jeremynguyenn/STM32-IoT-Development-board-Hardware-and-Firmware/README.md

Relate to this firmware git: https://github.com/jeremynguyenn/My-driver-Embedded-IoT-Frimware.git
