jeremynguyenn/STM32-IoT-Development-board-Hardware-and-Firmware/IOT development board firmware and hardware/UnderControl-Prototype-main/README.md

# STM32-GPS-GSM-IoT-Board-UnderControl-
IoT board to control smart home and car systems via Bluetooth, wifi, and GSM with embedded CAN transceiver for OBD.
Note: For Sch, Gerber and assembly files or any info you can contact me.
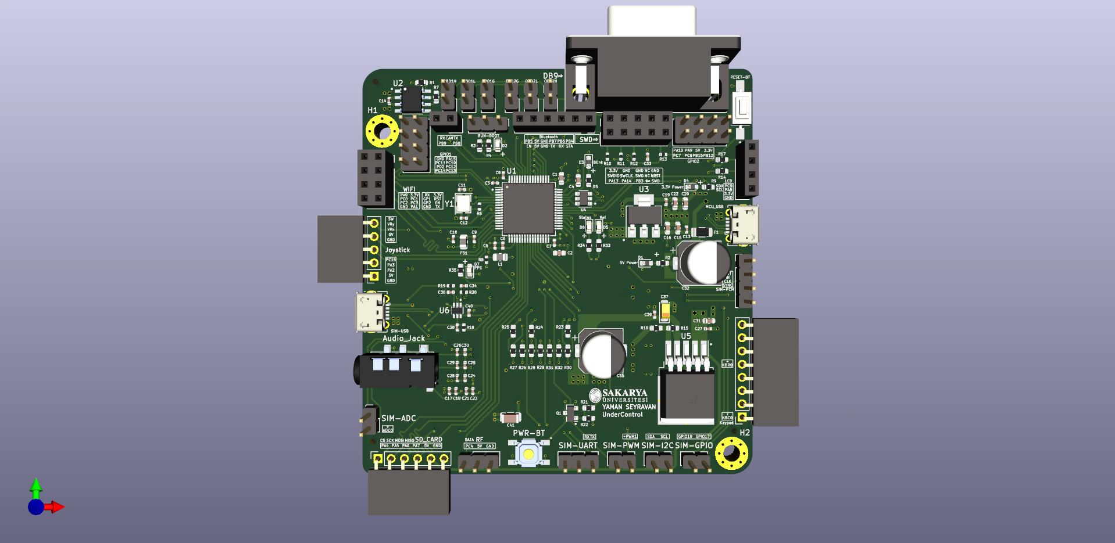
[picture p1: IOT development board firmware and hardware/UnderControl-Prototype-main/pic_PCBversion/Under-Control-F.jpg]

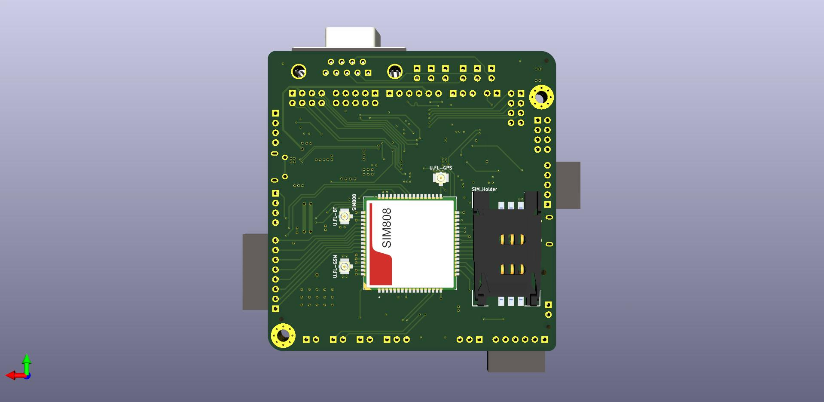
[picture p2: IOT development board firmware and hardware/UnderControl-Prototype-main/pic_PCBversion/Under-Control-B.jpg]

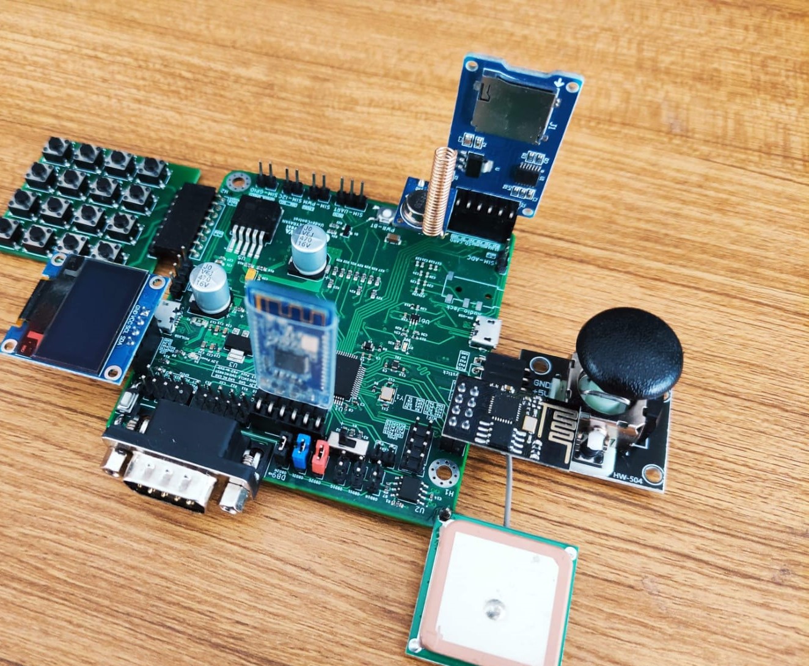
[picture p3: IOT development board firmware and hardware/UnderControl-Prototype-main/pic_PCBversion/UC_F.jpeg]
