jeremynguyenn/STM32-IoT-Development-board-Hardware-and-Firmware/IOT development board firmware and hardware/UnderControl-Prototype-main/Hardware Design/UnderControl.png

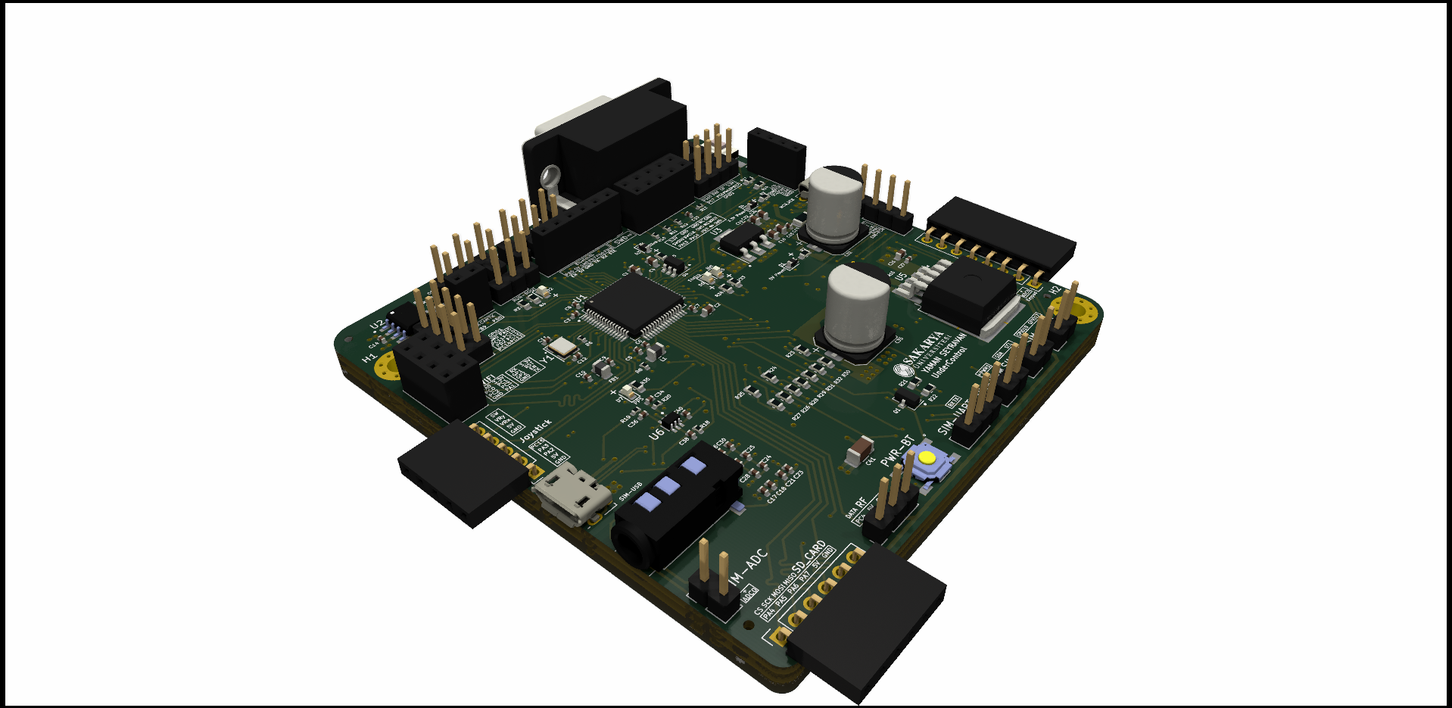
IOT development board firmware and hardware/UnderControl-Prototype-main/Hardware Design/UnderControl.png
