jeremynguyenn/STM32-IoT-Development-board-Hardware-and-Firmware/IOT development board firmware and hardware/UnderControl-Prototype-main/pic_PCBversion/Under-Control-S.jpg

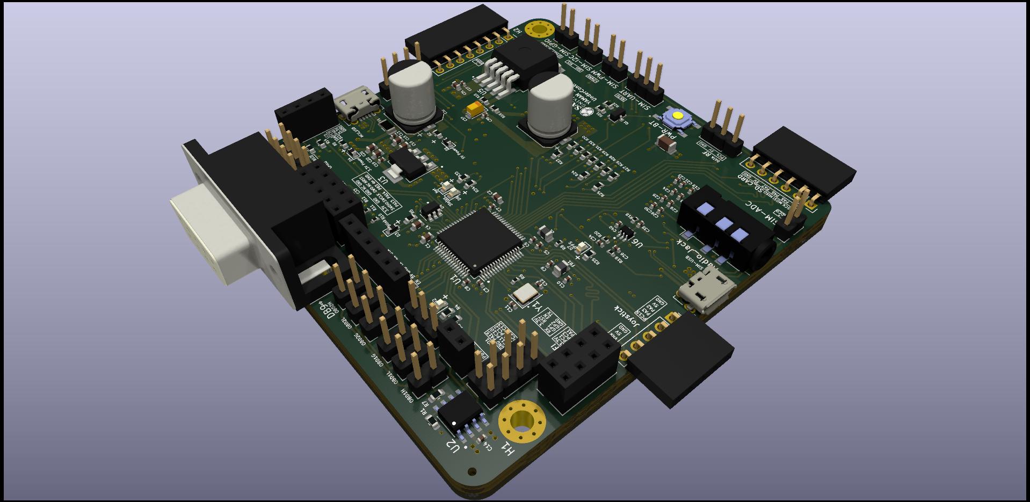
IOT development board firmware and hardware/UnderControl-Prototype-main/pic_PCBversion/Under-Control-S.jpg
