jeremynguyenn/STM32-IoT-Development-board-Hardware-and-Firmware/IOT development board firmware and hardware/UnderControl-Prototype-main/pic_PCBversion/UnderControl-front.jpg

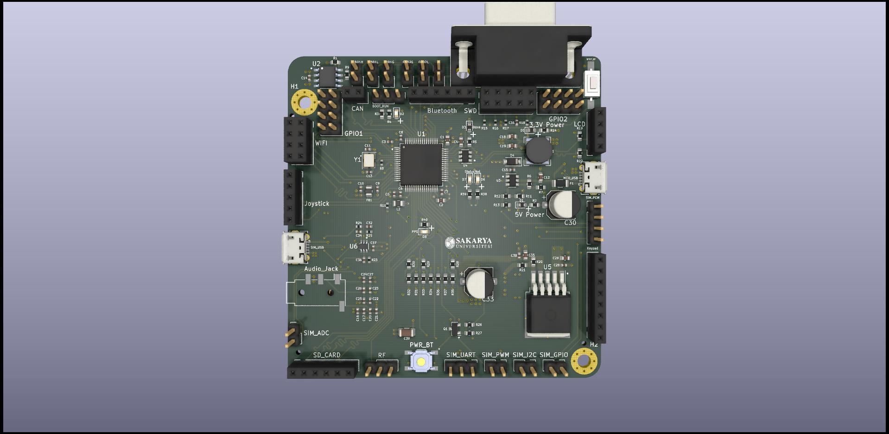
IOT development board firmware and hardware/UnderControl-Prototype-main/pic_PCBversion/UnderControl-front.jpg
