jeremynguyenn/STM32-IoT-Development-board-Hardware-and-Firmware/IOT development board firmware and hardware/UnderControl-Prototype-main/pic_PCBversion/UnderControl-side.jpg

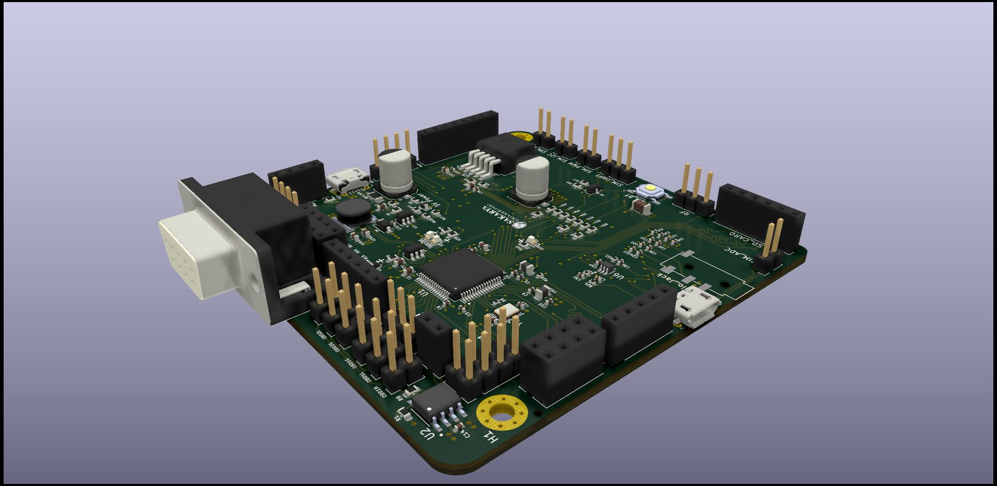
IOT development board firmware and hardware/UnderControl-Prototype-main/pic_PCBversion/UnderControl-side.jpg
