jeremynguyenn/STM32-IoT-Development-board-Hardware-and-Firmware/IOT development board firmware and hardware/UnderControl-Prototype-main/Hardware Design/UnderControl.kicad_pcb

## KiCad design IOT development board firmware and hardware/UnderControl-Prototype-main/Hardware Design/UnderControl.kicad_pcb (2025-09-02)

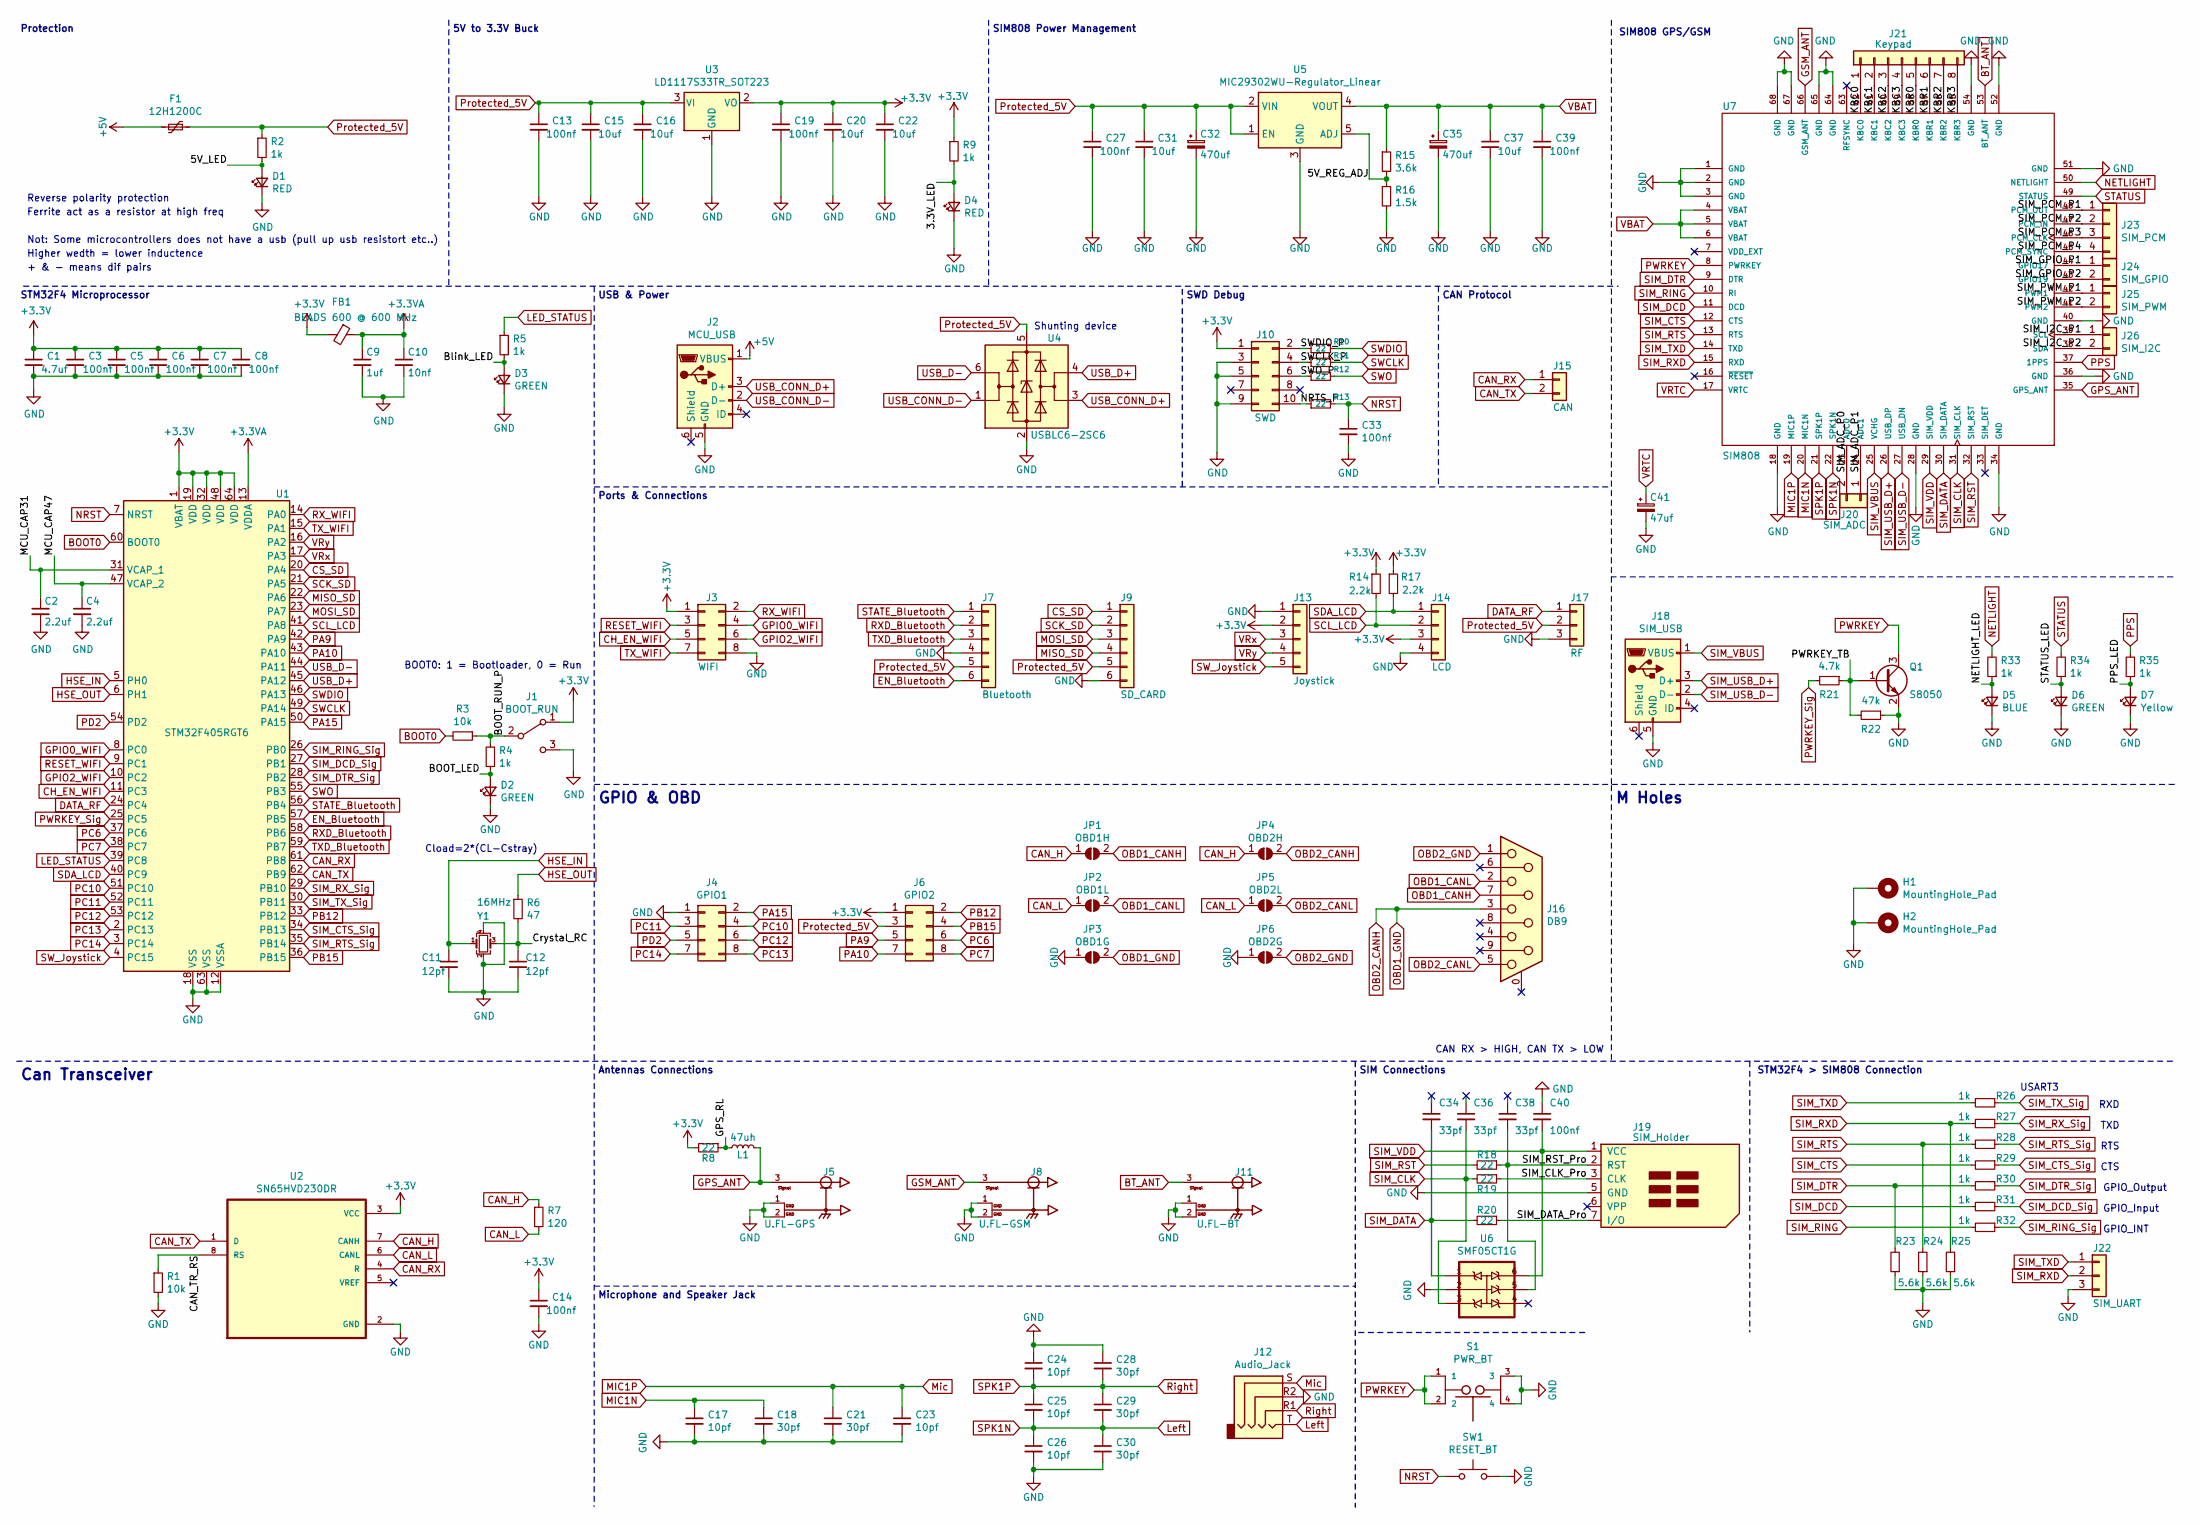
[picture p9: schematic UnderControl.kicad_sch]

Parts:
C1: 4.7uf; C_0603_1608Metric; LCSC Part # C19666
C2, C4: 2.2uf; C_0603_1608Metric; LCSC Part # C23630
C3, C5, C6, C7, C8, C13, C14, C19, C27, C33, C39, C40: 100nf; C_0402_1005Metric; LCSC Part # C1525
C9: 1uf; C_0402_1005Metric; LCSC Part # C52923
C10: 10nf; C_0402_1005Metric; LCSC Part # C15195
C11, C12: 12pf; C_0402_1005Metric; LCSC Part # C1547
C15, C16, C20, C22, C31: 10uf; C_0603_1608Metric; LCSC Part # C19702
C17, C23, C24, C25, C26: 10pf; C_0402_1005Metric; LCSC Part # C32949
C18, C21, C28, C29, C30: 30pf; C_0402_1005Metric; LCSC Part # C1570
C32, C35: 470uf; CP_Elec_8x10; LCSC Part # C176671
C34, C36, C38: 33pf; C_0402_1005Metric; LCSC Part # C1562
C37: 10uf; CP_EIA-3216-18_Kemet-A; LCSC Part # C7171
C41: 47uf; C_1206_3216Metric; LCSC Part # C96123
D1, D4: RED; D_0603_1608Metric; LCSC Part # C2286
D2, D6: GREEN; LED_0603_1608Metric; LCSC Part # C72043
D3: GREEN; D_0603_1608Metric; LCSC Part # C72043
D5: BLUE; LED_0603_1608Metric; LCSC Part # C72041
D7: Yellow; LED_0603_1608Metric; LCSC Part # C72038
F1: 12H1200C; Fuse_1206_3216Metric; LCSC Part # C182310
FB1: BEADS 600 @ 600 MHz; L_0805_2012Metric; LCSC Part # C1017
H1, H2: MountingHole_Pad; MountingHole_3.2mm_M3_Pad_Via
J1: BOOT_RUN; PinHeader_1x03_P2.54mm_Vertical
J2: MCU_USB; USB_Micro_JLCPCB; LCSC Part # C404969
J3: WIFI; PinSocket_2x04_P2.54mm_Vertical
J4: GPIO1; PinHeader_2x04_P2.54mm_Vertical
J5: U.FL-GPS; HRS_U.FL-R-SMT(01); LCSC Part # C88374
J6: GPIO2; PinHeader_2x04_P2.54mm_Vertical
J7: Bluetooth; PinSocket_1x06_P2.54mm_Vertical
J8: U.FL-GSM; HRS_U.FL-R-SMT(01); LCSC Part # C88374
J9: SD_CARD; PinSocket_1x06_P2.54mm_Vertical
J10: SWD; PinSocket_2x05_P2.54mm_Vertical
J11: U.FL-BT; HRS_U.FL-R-SMT(01); LCSC Part # C88374
J12: Audio_Jack; Jack_3.5mm_PJ320D_Horizontal
J13: Joystick; PinSocket_1x05_P2.54mm_Vertical
J14: LCD; PinSocket_1x04_P2.54mm_Vertical
J15: CAN; PinSocket_1x02_P2.54mm_Vertical
J16: DB9; DSUB-9_Female_Horizontal_P2.77x2.84mm_EdgePinOffset4.94mm_H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
J17: RF; PinHeader_1x03_P2.54mm_Vertical
J18: SIM_USB; USB_Micro_JLCPCB; LCSC Part # C404969
J19: SIM_Holder; FCI_7111S2015X02LF
J20: SIM_ADC; PinHeader_1x02_P2.54mm_Vertical
J21: Keypad; PinSocket_1x08_P2.54mm_Vertical
J22: SIM_UART; PinHeader_1x03_P2.54mm_Vertical
J23: SIM_PCM; PinHeader_1x04_P2.54mm_Vertical
J24: SIM_GPIO; PinHeader_1x02_P2.54mm_Vertical
J25: SIM_PWM; PinHeader_1x02_P2.54mm_Vertical
J26: SIM_I2C; PinHeader_1x02_P2.54mm_Vertical
JP1: OBD1H; PinHeader_1x02_P2.54mm_Vertical
JP2: OBD1L; PinHeader_1x02_P2.54mm_Vertical
JP3: OBD1G; PinHeader_1x02_P2.54mm_Vertical
JP4: OBD2H; PinHeader_1x02_P2.54mm_Vertical
JP5: OBD2L; PinHeader_1x02_P2.54mm_Vertical
JP6: OBD2G; PinHeader_1x02_P2.54mm_Vertical
L1: 47uh; L_0805_2012Metric; LCSC Part # C14304
Q1: S8050; SOT-23; LCSC Part # C2146
R1, R3: 10k; R_0603_1608Metric; LCSC Part # C25804
R2, R4, R5, R9, R26, R27, R28, R29, R30, R31, R32, R33, R34, R35: 1k; R_0603_1608Metric; LCSC Part # C21190
R6: 47; R_0402_1005Metric; LCSC Part # C25118
R7: 120; R_0603_1608Metric; LCSC Part # C22787
R8, R10, R11, R12, R13, R18, R19, R20: 22; R_0402_1005Metric; LCSC Part # C25092
R14, R17: 2.2k; R_0603_1608Metric; LCSC Part # C4190
R15: 3.6k; R_0603_1608Metric; LCSC Part # C22980
R16: 1.5k; R_0603_1608Metric; LCSC Part # C22843
R21: 4.7k; R_0603_1608Metric; LCSC Part # C23162
R22: 47k; R_0603_1608Metric; LCSC Part # C25819
R23, R24, R25: 5.6k; R_0603_1608Metric; LCSC Part # C23189
S1: PWR_BT; SW_TL3342F160QG
SW1: RESET_BT; SW_1437566-4
U1: STM32F405RGT6; LQFP-64_10x10mm_P0.5mm; LCSC Part # C15742
U2: SN65HVD230DR; SOIC127P599X175-8N; LCSC Part C12084
U3: LD1117S33TR_SOT223; SOT-223-3_TabPin2; LCSC Part C86781
U4: USBLC6-2SC6; SOT-23-6; LCSC Part # C7519
U5: MIC29302WU-Regulator_Linear; TO-263-5_TabPin3; LCSC Part C11149
U6: SMF05CT1G; SOT65P210X110-6N; LCSC Part # C15879
U7: SIM808; XCVR_SIM808
Y1: 16MHz; Crystal_SMD_3225-4Pin_3.2x2.5mm; LCSC Part # C13738

Connections:
+3.3VA: C9.1, C10.1, FB1.1, U1.13 (VDDA)
+3V3: C1.1, C3.1, C5.1, C6.1, C7.1, C8.1, C14.1, C19.1, C20.1, C22.1, FB1.2, J1.1 (A), J3.1, J6.1, J10.1, J13.2, J14.3, R8.2, R9.1, R14.1, R17.1, U1.1 (VBAT), U1.19 (VDD), U1.32 (VDD), U1.48 (VDD), U1.64 (VDD), U2.3 (VCC), U3.2 (VO)
+5V: F1.2, J2.1 (VBUS)
/3.3V_LED: D4.2 (A), R9.2
/5V_LED: D1.2 (A), R2.2
/5V_REG_ADJ: R15.2, R16.1, U5.5 (ADJ)
/BOOT_LED: D2.2 (A), R4.1
/BOOT_RUN_P: J1.2 (B), R3.1, R4.2
/Blink_LED: D3.2 (A), R5.2
/CAN_TR_RS: R1.1, U2.8 (RS)
/Crystal_RC: C12.1, R6.2, Y1.3
/GPS_RL: L1.1, R8.1
/KBC0: J21.1, U7.62 (KBC0)
/KBC1: J21.2, U7.61 (KBC1)
/KBC2: J21.3, U7.60 (KBC2)
/KBC3: J21.4, U7.59 (KBC3)
/KBR0: J21.5, U7.58 (KBR0)
/KBR1: J21.6, U7.57 (KBR1)
/KBR2: J21.7, U7.56 (KBR2)
/KBR3: J21.8, U7.55 (KBR3)
/MCU_CAP31: C2.1, U1.31 (VCAP_1)
/MCU_CAP47: C4.1, U1.47 (VCAP_2)
/NETLIGHT_LED: D5.2 (A), R33.1
/NRTS_P: J10.10, R13.1
/PPS_LED: D7.2 (A), R35.1
/PWRKEY_TB: Q1.1 (B), R21.1, R22.2
/SIM_ADC_P0: J20.2, U7.23 (ADC0)
/SIM_ADC_P1: J20.1, U7.24 (ADC1)
/SIM_CLK_Pro: J19.3 (CLK), R19.1
/SIM_DATA_Pro: J19.7 (I/O), R20.1
/SIM_GPIO_P1: J24.1, U7.44 (GPIO17)
/SIM_GPIO_P2: J24.2, U7.43 (GPIO19)
/SIM_I2C_P1: J26.1, U7.39 (SCL)
/SIM_I2C_P2: J26.2, U7.38 (SDA)
/SIM_PCM_P1: J23.1, U7.48 (PCM_OUT)
/SIM_PCM_P2: J23.2, U7.47 (PCM_IN)
/SIM_PCM_P3: J23.3, U7.46 (PCM_CLK)
/SIM_PCM_P4: J23.4, U7.45 (PCM_SYNC)
/SIM_PWM_P1: J25.1, U7.42 (PWM1)
/SIM_PWM_P2: J25.2, U7.41 (PWM2)
/SIM_RST_Pro: C38.2, J19.2 (RST), R18.1, U6.5
/STATUS_LED: D6.2 (A), R34.1
/SWCLK_P: J10.4, R11.1
/SWDIO_P: J10.2, R10.1
/SWO_P: J10.6, R12.1
BOOT0: R3.2, U1.60 (BOOT0)
BT_ANT: J11.3, U7.53 (BT_ANT)
CAN_H: JP1.1 (A), JP4.1 (A), R7.1, U2.7 (CANH)
CAN_L: JP2.1 (A), JP5.1 (A), R7.2, U2.6 (CANL)
CAN_RX: J15.1, U1.61 (PB8), U2.4 (R)
CAN_TX: J15.2, U1.62 (PB9), U2.1 (D)
CH_EN_WIFI: J3.5, U1.11 (PC3)
CS_SD: J9.1, U1.20 (PA4)
DATA_RF: J17.1, U1.24 (PC4)
EN_Bluetooth: J7.6, U1.57 (PB5)
GND: C1.2, C2.2, C3.2, C4.2, C5.2, C6.2, C7.2, C8.2, C9.2, C10.2, C11.2, C12.2, C13.2, C14.2, C15.2, C16.2, C17.2, C18.2, C19.2, C20.2, C21.2, C22.2, C23.2, C24.1, C26.2, C27.2, C28.1, C30.2, C31.2, C32.2, C33.2, C35.2, C37.2, C39.2, C40.1, C41.2, D1.1 (K), D2.1 (K), D3.1 (K), D4.1 (K), D5.1 (K), D6.1 (K), D7.1 (K), H1.1, H2.1, J1.3 (C), J2.5 (GND), J3.8, J4.1, J5.1, J5.2, J7.4, J8.1, J8.2, J9.6, J10.3, J10.5, J10.9, J11.1, J11.2, J12.R2, J13.1, J14.4, J17.3, J18.5 (GND), J19.5 (GND), J22.3, JP3.1 (A), JP6.1 (A), Q1.2 (E), R1.2, R16.2, R22.1, R23.1, R24.1, R25.1, S1.3, S1.4, SW1.2, U1.12 (VSSA), U1.18 (VSS), U1.63 (VSS), U2.2 (GND), U3.1 (GND), U4.2 (GND), U5.3 (GND), U6.2, U7.1 (GND), U7.2 (GND), U7.3 (GND), U7.18 (GND), U7.28 (GND), U7.34 (GND), U7.36 (GND), U7.40 (GND), U7.51 (GND), U7.52 (GND), U7.54 (GND), U7.64 (GND), U7.65 (GND), U7.67 (GND), U7.68 (GND), Y1.2, Y1.4
GPIO0_WIFI: J3.4, U1.8 (PC0)
GPIO2_WIFI: J3.6, U1.10 (PC2)
GPS_ANT: J5.3, L1.2, U7.35 (GPS_ANT)
GSM_ANT: J8.3, U7.66 (GSM_ANT)
HSE_IN: C11.1, U1.5 (PH0), Y1.1
HSE_OUT: R6.1, U1.6 (PH1)
LED_STATUS: R5.1, U1.39 (PC8)
Left: C25.2, C26.1, C29.2, C30.1, J12.T, U7.22 (SPK1N)
MIC1N: C17.1, C18.1, U7.20 (MIC1N)
MIC1P: C21.1, C23.1, J12.S, U7.19 (MIC1P)
MISO_SD: J9.4, U1.22 (PA6)
MOSI_SD: J9.3, U1.23 (PA7)
NETLIGHT: R33.2, U7.50 (NETLIGHT)
NRST: C33.1, R13.2, SW1.1, U1.7 (NRST)
OBD1_CANH: J16.7, JP1.2 (B)
OBD1_CANL: J16.2, JP2.2 (B)
OBD1_GND: J16.3, JP3.2 (B), JP4.2 (B)
OBD2_CANL: J16.5, JP5.2 (B)
OBD2_GND: J16.1, JP6.2 (B)
PA9: J6.5, U1.42 (PA9)
PA10: J6.7, U1.43 (PA10)
PA15: J4.2, U1.50 (PA15)
PB12: J6.2, U1.33 (PB12)
PB15: J6.4, U1.36 (PB15)
PC6: J6.6, U1.37 (PC6)
PC7: J6.8, U1.38 (PC7)
PC10: J4.4, U1.51 (PC10)
PC11: J4.3, U1.52 (PC11)
PC12: J4.6, U1.53 (PC12)
PC13: J4.8, U1.2 (PC13)
PC14: J4.7, U1.3 (PC14)
PD2: J4.5, U1.54 (PD2)
PPS: R35.2, U7.37 (1PPS)
PWRKEY: Q1.3 (C), S1.1, S1.2, U7.8 (PWRKEY)
PWRKEY_Sig: R21.2, U1.25 (PC5)
Protected_5V: C13.1, C15.1, C16.1, C27.1, C31.1, C32.1, F1.1, J6.3, J7.5, J9.5, J17.2, R2.1, U3.3 (VI), U4.5 (VBUS), U5.1 (EN), U5.2 (VIN)
RESET_WIFI: J3.3, U1.9 (PC1)
RXD_Bluetooth: J7.2, U1.58 (PB6)
RX_WIFI: J3.2, U1.14 (PA0)
Right: C24.2, C25.1, C28.2, C29.1, J12.R1, U7.21 (SPK1P)
SCK_SD: J9.2, U1.21 (PA5)
SCL_LCD: J14.2, R14.2, U1.41 (PA8)
SDA_LCD: J14.1, R17.2, U1.40 (PC9)
SIM_CLK: C36.2, R19.2, U6.3, U7.31 (SIM_CLK)
SIM_CTS: R29.2, U7.12 (CTS)
SIM_CTS_Sig: R29.1, U1.34 (PB13)
SIM_DATA: C34.2, R20.2, U6.1, U7.30 (SIM_DATA)
SIM_DCD: R31.2, U7.11 (DCD)
SIM_DCD_Sig: R31.1, U1.27 (PB1)
SIM_DTR: R23.2, R30.2, U7.9 (DTR)
SIM_DTR_Sig: R30.1, U1.28 (PB2)
SIM_RING: R32.2, U7.10 (RI)
SIM_RING_Sig: R32.1, U1.26 (PB0)
SIM_RST: R18.2, U7.32 (SIM_RST)
SIM_RTS: R24.2, R28.2, U7.13 (RTS)
SIM_RTS_Sig: R28.1, U1.35 (PB14)
SIM_RXD: J22.2, R25.2, R27.2, U7.15 (RXD)
SIM_RX_Sig: R27.1, U1.29 (PB10)
SIM_TXD: J22.1, R26.2, U7.14 (TXD)
SIM_TX_Sig: R26.1, U1.30 (PB11)
SIM_USB_D+: J18.3 (D+), U7.26 (USB_DP)
SIM_USB_D-: J18.2 (D-), U7.27 (USB_DN)
SIM_VBUS: J18.1 (VBUS), U7.25 (VCHG)
SIM_VDD: C40.2, J19.1 (VCC), U6.6, U7.29 (SIM_VDD)
STATE_Bluetooth: J7.1, U1.56 (PB4)
STATUS: R34.2, U7.49 (STATUS)
SWCLK: R11.2, U1.49 (PA14)
SWDIO: R10.2, U1.46 (PA13)
SWO: R12.2, U1.55 (PB3)
SW_Joystick: J13.5, U1.4 (PC15)
TXD_Bluetooth: J7.3, U1.59 (PB7)
TX_WIFI: J3.7, U1.15 (PA1)
USB_CONN_D+: J2.3 (D+), U4.3 (I/O2)
USB_CONN_D-: J2.2 (D-), U4.1 (I/O1)
USB_D+: U1.45 (PA12), U4.4 (I/O2)
USB_D-: U1.44 (PA11), U4.6 (I/O1)
VBAT: C35.1, C37.1, C39.1, R15.1, U5.4 (VOUT), U7.4 (VBAT), U7.5 (VBAT), U7.6 (VBAT)
VRTC: C41.1, U7.17 (VRTC)
VRx: J13.3, U1.17 (PA3)
VRy: J13.4, U1.16 (PA2)

Notes on the sheet:
Protection
STM32F4 Microprocessor
Can Transceiver
Reverse polarity protection
Ferrite act as a resistor at high freq
Not: Some microcontrollers does not have a usb (pull up usb resistort etc..)
Higher wedth = lower inductence
+ & - means dif pairs
BOOT0: 1 = Bootloader, 0 = Run
Cload=2*(CL-Cstray)
5V to 3.3V Buck
USB & Power
Ports & Connections
GPIO & OBD
Antennas Connections
Microphone and Speaker Jack
SIM808 Power Management
Shunting device
SWD Debug
SIM Connections
CAN RX > HIGH, CAN TX > LOW
CAN Protocol
M Holes
SIM808 GPS/GSM
STM32F4 > SIM808 Connection
USART3
GPIO_Output
GPIO_Input
GPIO_INT
RXD
TXD
RTS
CTS

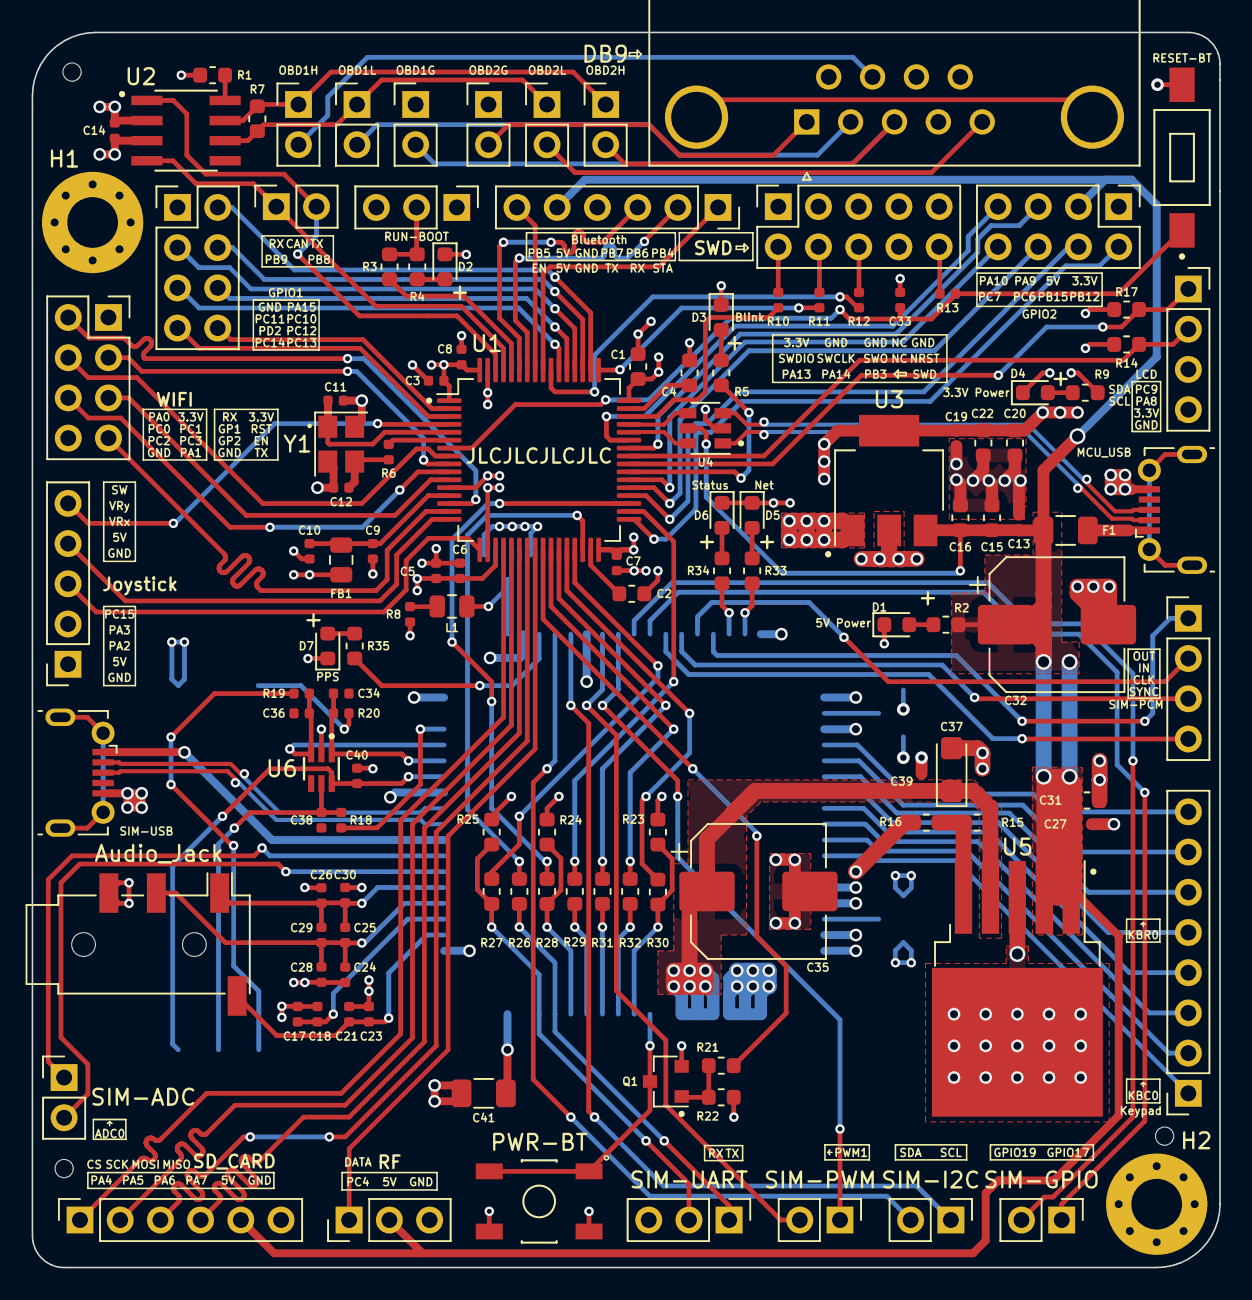
[picture p10: board UnderControl.kicad_pcb from above]

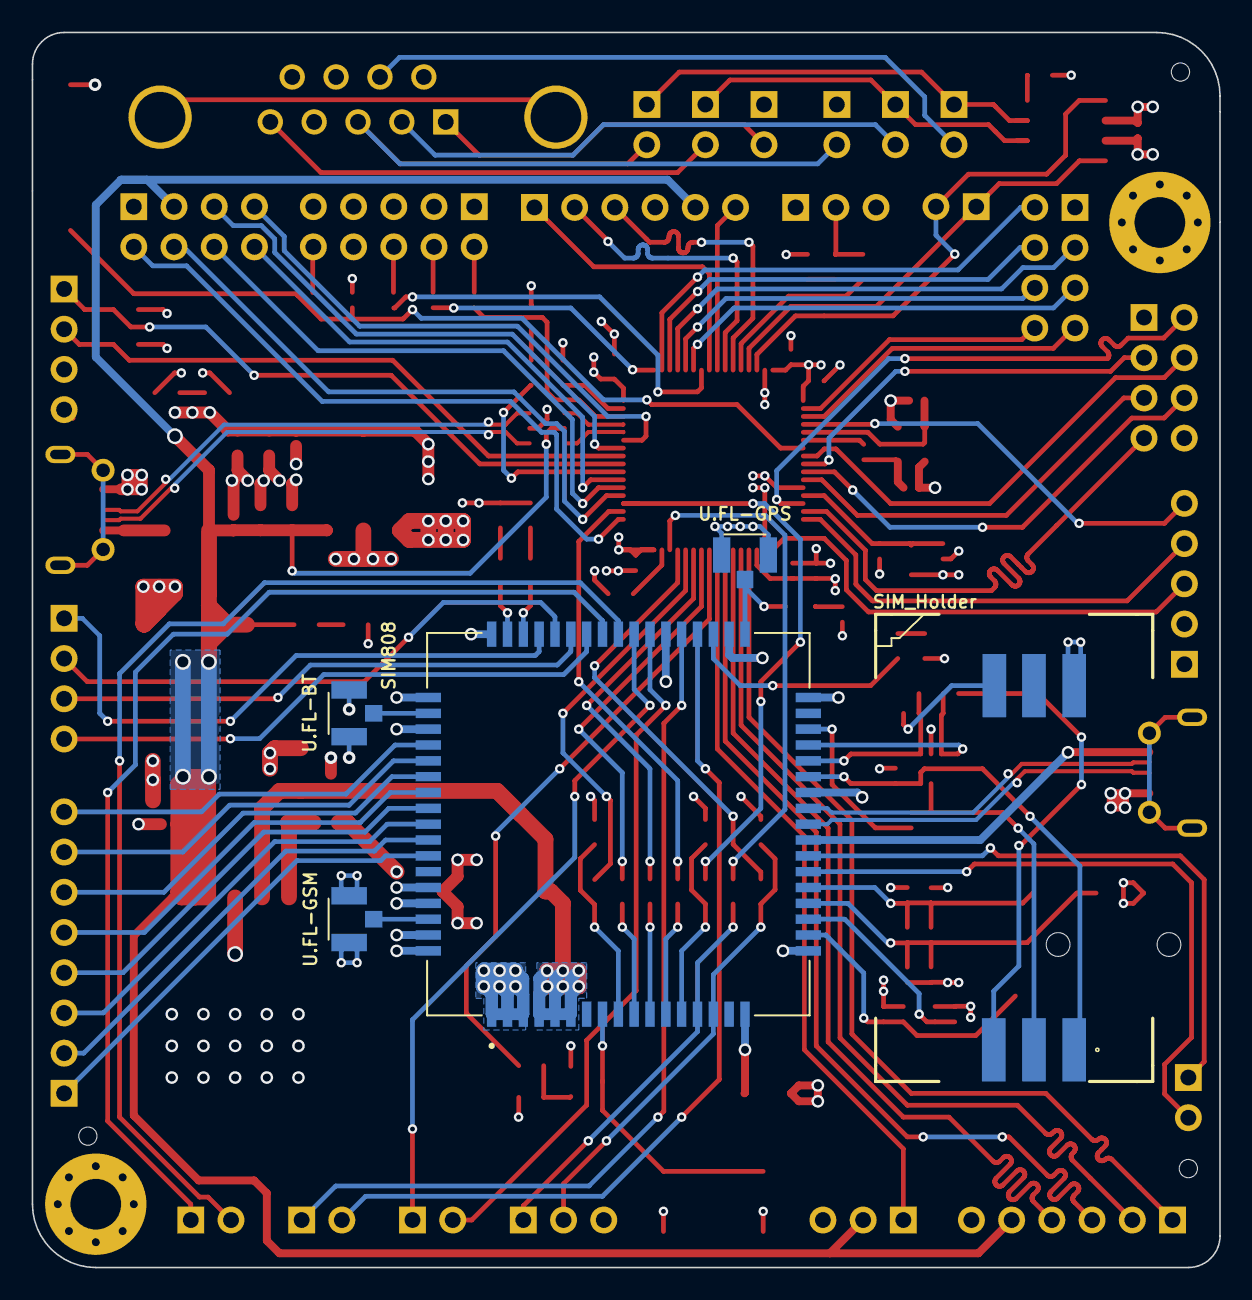
[picture p11: board UnderControl.kicad_pcb from below]

Board: 4 copper layers, 75.0 x 78.0 mm, 131 parts (5 on the bottom side), 136 nets.
