jeremynguyenn/STM32-IoT-Development-board-Hardware-and-Firmware/IOT development board firmware and hardware/UnderControl_Hardware_Design-main/Hardware Design/UnderControl_V6.kicad_pcb

## KiCad design IOT development board firmware and hardware/UnderControl_Hardware_Design-main/Hardware Design/UnderControl_V6.kicad_pcb (2025-09-02)

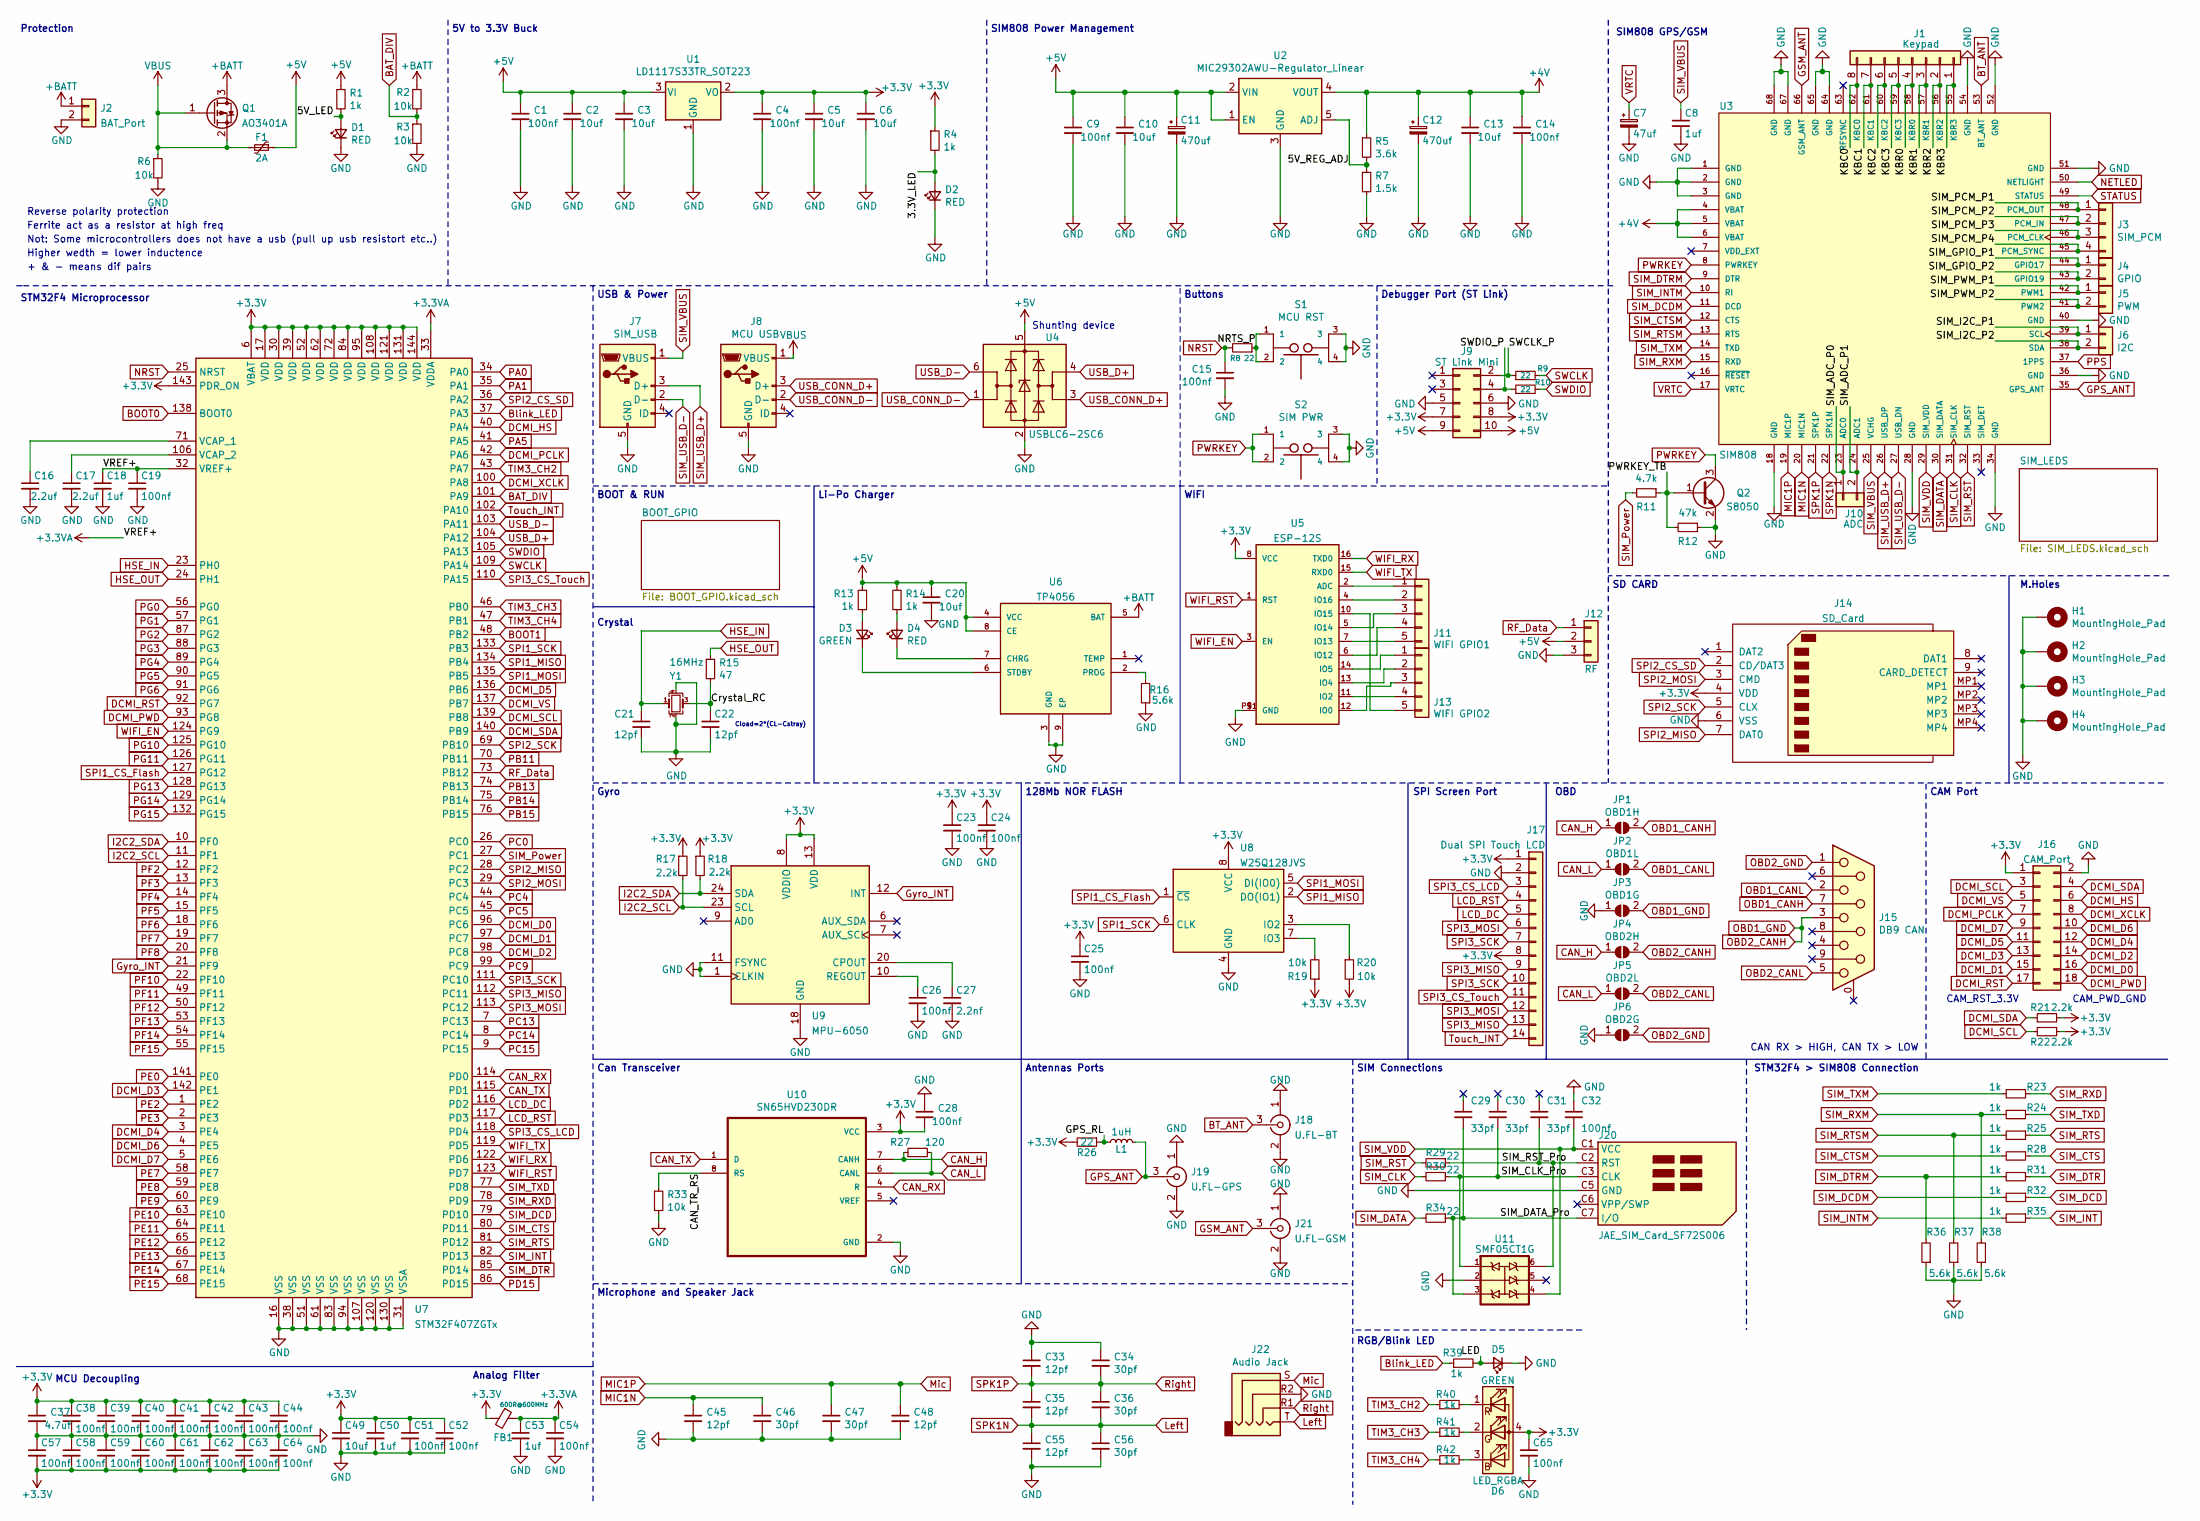
[picture p12: schematic UnderControl_V6.kicad_sch, UnderControl]

Parts:
C1, C4, C9, C14, C15, C19, C23, C24, C25, C26, C28, C32, C38, C39, C40, C41, C42, C43, C44, C51, C52, C54, C57, C58, C59, C60, C61, C62, C63, C64, C65: 100nf; C_0402_1005Metric; LCSC C1525
C2, C3, C5, C6, C10, C13, C20, C49: 10uf; C_0603_1608Metric; LCSC C19702
C7: 47uf; C_1206_3216Metric; LCSC C96123
C8, C18, C50, C53: 1uf; C_0402_1005Metric; LCSC C52923
C11, C12: 470uf; CP_Elec_6.3x7.7; LCSC C134738
C16, C17: 2.2uf; C_0402_1005Metric; LCSC C12530
C21, C22, C33, C35, C45, C48, C55: 12pf; C_0402_1005Metric; LCSC C1547
C27: 2.2nf; C_0402_1005Metric; LCSC C1531
C29, C30, C31: 33pf; C_0402_1005Metric; LCSC C1531
C34, C36, C46, C47, C56: 30pf; C_0402_1005Metric; LCSC C1570
C37: 4.7uf; C_0402_1005Metric; LCSC C23733
D1, D2, D4: RED; LED_0805_2012Metric; LCSC C84256
D3, D5: GREEN; LED_0603_1608Metric; LCSC C72043
D6: LED_RGBA; 19237R6GHBHCA012T; LCSC C60105
F1: 2A; Fuse_1206_3216Metric; LCSC C187595
FB1: 600R@600MHz; L_0805_2012Metric; LCSC C1017
H1, H2, H3, H4: MountingHole_Pad; MountingHole_2.5mm_Pad_Via
J1: Keypad; PinSocket_1x08_P2.54mm_Vertical
J2: BAT_Port; JST_B2B-XH-A(LF)(SN)
J3: SIM_PCM; PinHeader_1x04_P2.54mm_Vertical
J4: GPIO; PinHeader_1x02_P2.54mm_Vertical
J5: PWM; PinHeader_1x02_P2.54mm_Vertical
J6: I2C; PinHeader_1x02_P2.54mm_Vertical
J7: SIM_USB; AMPHENOL_10118194-0001LF; LCSC C132563
J8: MCU USB; AMPHENOL_10118194-0001LF; LCSC C132563
J9: ST Link Mini; PinSocket_2x05_P2.54mm_Horizontal
J10: ADC; PinHeader_1x02_P2.54mm_Vertical
J11: WIFI GPIO1; PinSocket_1x05_P2.54mm_Vertical
J12: RF; PinHeader_1x03_P2.54mm_Vertical
J13: WIFI GPIO2; PinSocket_1x05_P2.54mm_Vertical
J14: SD_Card; TF15X15; LCSC C111196
J15: DB9 CAN; DSUB-9_Female_Horizontal_P2.77x2.84mm_EdgePinOffset4.94mm_H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
J16: CAM_Port; PinSocket_2x09_P2.54mm_Vertical
J17: Dual SPI Touch LCD; PinSocket_1x14_P2.54mm_Vertical
J18: U.FL-BT; HRS_U.FL-R-SMT(01); LCSC C88374
J19: U.FL-GPS; HRS_U.FL-R-SMT(01); LCSC C88374
J20: JAE_SIM_Card_SF72S006; GCT_SIM8060-6-1-14-00-A; LCSC C410356
J21: U.FL-GSM; HRS_U.FL-R-SMT(01); LCSC C88374
J22: Audio Jack; Jack_3.5mm_PJ320D_Horizontal
JP1: OBD1H; SolderJumper-2_P1.3mm_Open_TrianglePad1.0x1.5mm
JP2: OBD1L; SolderJumper-2_P1.3mm_Open_TrianglePad1.0x1.5mm
JP3: OBD1G; SolderJumper-2_P1.3mm_Open_TrianglePad1.0x1.5mm
JP4: OBD2H; SolderJumper-2_P1.3mm_Open_TrianglePad1.0x1.5mm
JP5: OBD2L; SolderJumper-2_P1.3mm_Open_TrianglePad1.0x1.5mm
JP6: OBD2G; SolderJumper-2_P1.3mm_Open_TrianglePad1.0x1.5mm
L1: 1uH; L_0805_2012Metric; LCSC C1042
Q1: AO3401A; SOT-23; LCSC C15127
Q2: S8050; SOT-23; LCSC C2146
R1, R4, R13, R14, R23, R24, R25, R28, R31, R32, R35, R39, R40, R41, R42: 1k; R_0402_1005Metric; LCSC C11702
R2, R3, R6, R19, R20, R33: 10k; R_0402_1005Metric; LCSC C25744
R5: 3.6k; R_0603_1608Metric; LCSC C22980
R7: 1.5k; R_0603_1608Metric; LCSC C22843
R8, R9, R10, R26, R29, R30, R34: 22; R_0402_1005Metric; LCSC C25092
R11: 4.7k; R_0402_1005Metric; LCSC C25900
R12: 47k; R_0402_1005Metric; LCSC C25792
R15: 47; R_0402_1005Metric; LCSC C25118
R16, R36, R37, R38: 5.6k; R_0402_1005Metric; LCSC C25908
R17, R18, R21, R22: 2.2k; R_0402_1005Metric; LCSC C25879
R27: 120; R_0402_1005Metric; LCSC C25079
S1: MCU RST; SW_TL3342F160QG; LCSC C318884
S2: SIM PWR; SW_TL3342F160QG; LCSC C318884
U1: LD1117S33TR_SOT223; SOT-223-3_TabPin2; LCSC C86781
U2: MIC29302AWU-Regulator_Linear; TO-263-5_TabPin3; LCSC C411869
U3: SIM808; XCVR_SIM808; LCSC C126275
U4: USBLC6-2SC6; SOT-23-6; LCSC C2827654
U5: ESP-12S; LCSC C82898
U6: TP4056; SOIC127P600X175-9N; LCSC C16581
U7: STM32F407ZGTx; LQFP-144_20x20mm_P0.5mm; LCSC C19156
U8: W25Q128JVS; SOIC-8_5.23x5.23mm_P1.27mm; LCSC C97521
U9: MPU-6050; InvenSense_QFN-24_4x4mm_P0.5mm_NoMask; LCSC C24112
U10: SN65HVD230DR; SOIC127P599X175-8N; LCSC C12084
U11: SMF05CT1G; SOT65P210X110-6N; LCSC C15879
Y1: 16MHz; Crystal_SMD_3225-4Pin_3.2x2.5mm; LCSC C13738

Connections:
+3.3VA: C18.1, C19.1, C53.1, C54.1, FB1.1, U7.32 (VREF+), U7.33 (VDDA)
+3V3: C4.1, C5.1, C6.1, C23.1, C24.1, C25.1, C28.2, C37.1, C38.1, C39.1, C40.1, C41.1, C42.1, C43.1, C44.1, C49.1, C50.1, C51.1, C52.1, C57.2, C58.2, C59.2, C60.2, C61.2, C62.2, C63.2, C64.2, C65.1, D6.4 (A), FB1.2, J9.7, J9.8, J14.4 (VDD), J16.1, J17.1, J17.8, R4.1, R17.1, R18.1, R19.1, R20.2, R21.1, R22.1, R26.2, U1.2 (VO), U5.8 (VCC), U7.6 (VBAT), U7.17 (VDD), U7.30 (VDD), U7.39 (VDD), U7.52 (VDD), U7.62 (VDD), U7.72 (VDD), U7.84 (VDD), U7.95 (VDD), U7.108 (VDD), U7.121 (VDD), U7.131 (VDD), U7.143 (PDR_ON), U7.144 (VDD), U8.8 (VCC), U9.8 (VDDIO), U9.13 (VDD), U10.3 (VCC); also elsewhere on the board
+4V: C12.1, C13.1, C14.1, R5.1, U2.4 (VOUT), U3.4 (VBAT), U3.5 (VBAT), U3.6 (VBAT)
+5V: C1.1, C2.1, C3.1, C9.1, C10.1, C11.1, C20.1, F1.1, J9.9, J9.10, J12.2, R1.1, R13.2, R14.2, U1.3 (VI), U2.1 (EN), U2.2 (VIN), U4.5 (VBUS), U6.4 (VCC), U6.8 (CE); also elsewhere on the board
+BATT: J2.1, Q1.3 (D), R2.1, U6.5 (BAT)
/3.3V_LED: D2.2 (A), R4.2
/5V_LED: D1.2 (A), R1.2
/5V_REG_ADJ: R5.2, R7.1, U2.5 (ADJ)
/CAN_TR_RS: R33.1, U10.8 (RS)
/Crystal_RC: C22.1, R15.2, Y1.3
/GPS_RL: L1.1, R26.1
/KBC0: J1.8, U3.62 (KBC0)
/KBC1: J1.7, U3.61 (KBC1)
/KBC2: J1.6, U3.60 (KBC2)
/KBC3: J1.5, U3.59 (KBC3)
/KBR0: J1.4, U3.58 (KBR0)
/KBR1: J1.3, U3.57 (KBR1)
/KBR2: J1.2, U3.56 (KBR2)
/KBR3: J1.1, U3.55 (KBR3)
/LED: D5.2 (A), R39.2
/NRTS_P: R8.1, S1.1, S1.2
/PWRKEY_TB: Q2.1 (B), R11.1, R12.2
/SIM_ADC_P0: J10.1, U3.23 (ADC0)
/SIM_ADC_P1: J10.2, U3.24 (ADC1)
/SIM_CLK_Pro: C30.2, J20.C3 (CLK), R30.1, U11.1
/SIM_DATA_Pro: C29.2, J20.C7 (I/O), R34.1, U11.3
/SIM_GPIO_P1: J4.1, U3.44 (GPIO17)
/SIM_GPIO_P2: J4.2, U3.43 (GPIO19)
/SIM_I2C_P1: J6.1, U3.39 (SCL)
/SIM_I2C_P2: J6.2, U3.38 (SDA)
/SIM_PCM_P1: J3.1, U3.48 (PCM_OUT)
/SIM_PCM_P2: J3.2, U3.47 (PCM_IN)
/SIM_PCM_P3: J3.3, U3.46 (PCM_CLK)
/SIM_PCM_P4: J3.4, U3.45 (PCM_SYNC)
/SIM_PWM_P1: J5.1, U3.42 (PWM1)
/SIM_PWM_P2: J5.2, U3.41 (PWM2)
/SIM_RST_Pro: C31.2, J20.C2 (RST), R29.1, U11.6
/SWCLK_P: J9.2, R9.1
/SWDIO_P: J9.4, R10.1
BAT_DIV: R2.2, R3.1, U7.101 (PA9)
BOOT0: U7.138 (BOOT0); also elsewhere on the board
BOOT1: U7.48 (PB2); also elsewhere on the board
BT_ANT: J18.3 (GND), U3.53 (BT_ANT)
Blink_LED: R39.1, U7.37 (PA3)
CAN_H: JP1.1 (A), JP4.1 (A), R27.1, U10.7 (CANH)
CAN_L: JP2.1 (A), JP5.1 (A), R27.2, U10.6 (CANL)
CAN_RX: U7.114 (PD0), U10.4 (R)
CAN_TX: U7.115 (PD1), U10.1 (D)
DCMI_D0: J16.16, U7.96 (PC6)
DCMI_D1: J16.15, U7.97 (PC7)
DCMI_D2: J16.14, U7.98 (PC8)
DCMI_D3: J16.13, U7.142 (PE1)
DCMI_D4: J16.12, U7.3 (PE4)
DCMI_D5: J16.11, U7.136 (PB6)
DCMI_D6: J16.10, U7.4 (PE5)
DCMI_D7: J16.9, U7.5 (PE6)
DCMI_HS: J16.6, U7.40 (PA4)
DCMI_PCLK: J16.7, U7.42 (PA6)
DCMI_PWD: J16.18, U7.93 (PG8)
DCMI_RST: J16.17, U7.92 (PG7)
DCMI_SCL: J16.3, R22.2, U7.139 (PB8)
DCMI_SDA: J16.4, R21.2, U7.140 (PB9)
DCMI_VS: J16.5, U7.137 (PB7)
DCMI_XCLK: J16.8, U7.100 (PA8)
GND: C1.2, C2.2, C3.2, C4.2, C5.2, C6.2, C7.2, C8.2, C9.2, C10.2, C11.2, C12.2, C13.2, C14.2, C15.2, C16.2, C17.2, C18.2, C19.2, C20.2, C21.2, C22.2, C23.2, C24.2, C25.2, C26.2, C27.2, C28.1, C32.1, C33.1, C34.1, C37.2, C38.2, C39.2, C40.2, C41.2, C42.2, C43.2, C44.2, C45.2, C46.2, C47.2, C48.2, C49.2, C50.2, C51.2, C52.2, C53.2, C54.2, C55.2, C56.2, C57.1, C58.1, C59.1, C60.1, C61.1, C62.1, C63.1, C64.1, C65.2, D1.1 (K), D2.1 (K), D5.1 (K), H1.1, H2.1, H3.1, H4.1, J2.2, J7.5 (GND), J8.5 (GND), J9.5, J9.6, J12.3, J14.6 (VSS), J16.2, J17.2, J18.1 (In), J18.2 (GND), J19.1 (In), J19.2 (GND), J20.C5 (GND), J21.1 (In), J21.2 (GND), J22.R2, JP3.1 (A), JP6.1 (A), Q2.2 (E), R3.2, R6.2, R7.2, R12.1, R16.1, R33.2, R36.1, R37.1, R38.1, S1.3, S1.4, S2.3, S2.4, U1.1 (GND), U2.3 (GND), U3.1 (GND), U3.2 (GND), U3.3 (GND), U3.18 (GND), U3.28 (GND), U3.34 (GND), U3.36 (GND), U3.40 (GND), U3.51 (GND), U3.52 (GND), U3.54 (GND), U3.64 (GND), U3.65 (GND), U3.67 (GND), U3.68 (GND), U4.2 (GND), U5.9 (GND), U5.P$1 (GND), U6.3 (GND), U6.9 (EP), U7.16 (VSS), U7.31 (VSSA), U7.38 (VSS), U7.51 (VSS), U7.61 (VSS), U7.83 (VSS), U7.94 (VSS), U7.107 (VSS), U7.120 (VSS), U7.130 (VSS), U8.4 (GND), U9.1 (CLKIN), U9.11 (FSYNC), U9.18 (GND), U10.2 (GND), U11.2, Y1.2, Y1.4; also elsewhere on the board
GPS_ANT: J19.3 (GND), L1.2, U3.35 (GPS_ANT)
GSM_ANT: J21.3 (GND), U3.66 (GSM_ANT)
Gyro_INT: U7.21 (PF9), U9.12 (INT)
HSE_IN: C21.1, U7.23 (PH0), Y1.1
HSE_OUT: R15.1, U7.24 (PH1)
I2C2_SCL: R17.2, U7.11 (PF1), U9.23 (SCL)
I2C2_SDA: R18.2, U7.10 (PF0), U9.24 (SDA)
LCD_DC: J17.5, U7.116 (PD2)
LCD_RST: J17.4, U7.117 (PD3)
Left: C35.2, C36.2, C55.1, C56.1, J22.T, U3.22 (SPK1N)
MIC1N: C45.1, C46.1, U3.20 (MIC1N)
MIC1P: C47.1, C48.1, J22.S, U3.19 (MIC1P)
NETLED: U3.50 (NETLIGHT); also elsewhere on the board
NRST: C15.1, R8.2, U7.25 (NRST)
unnamed: C16.1, U7.71 (VCAP_1)
unnamed: C17.1, U7.106 (VCAP_2)
unnamed: C26.1, U9.10 (REGOUT)
unnamed: C27.1, U9.20 (CPOUT)
unnamed: D3.1 (K), U6.6 (STDBY)
unnamed: D3.2 (A), R13.1
unnamed: D4.1 (K), U6.7 (CHRG)
unnamed: D4.2 (A), R14.1
unnamed: D6.1 (RK), R40.2
unnamed: D6.2 (GK), R41.2
unnamed: D6.3 (BK), R42.2
unnamed: J11.1, U5.2 (ADC)
unnamed: J11.2, U5.4 (IO16)
unnamed: J11.3, U5.5 (IO14)
unnamed: J11.4, U5.6 (IO12)
unnamed: J11.5, U5.7 (IO13)
unnamed: J13.1, U5.14 (IO5)
unnamed: J13.2, U5.13 (IO4)
unnamed: J13.3, U5.12 (IO0)
unnamed: J13.4, U5.11 (IO2)
unnamed: J13.5, U5.10 (IO15)
unnamed: R16.2, U6.2 (PROG)
unnamed: R19.2, U8.7 (IO3)
unnamed: R20.1, U8.3 (IO2)
OBD1_CANH: J15.7, JP1.2 (B)
OBD1_CANL: J15.2, JP2.2 (B)
OBD1_GND: J15.3, JP3.2 (B), JP4.2 (B)
OBD2_CANL: J15.5, JP5.2 (B)
OBD2_GND: J15.1, JP6.2 (B)
PA0: U7.34 (PA0)
PA1: U7.35 (PA1)
PA5: U7.41 (PA5)
PB11: U7.70 (PB11)
PB13: U7.74 (PB13)
PB14: U7.75 (PB14)
PB15: U7.76 (PB15)
PC0: U7.26 (PC0)
PC4: U7.44 (PC4)
PC5: U7.45 (PC5)
PC9: U7.99 (PC9); also elsewhere on the board
PC13: U7.7 (PC13)
PC14: U7.8 (PC14)
PC15: U7.9 (PC15)
PD15: U7.86 (PD15)
PE0: U7.141 (PE0)
PE2: U7.1 (PE2)
PE3: U7.2 (PE3)
PE7: U7.58 (PE7); also elsewhere on the board
PE8: U7.59 (PE8); also elsewhere on the board
PE9: U7.60 (PE9)
PE10: U7.63 (PE10)
PE11: U7.64 (PE11); also elsewhere on the board
PE12: U7.65 (PE12)
PE13: U7.66 (PE13)
PE14: U7.67 (PE14)
PE15: U7.68 (PE15)
PF2: U7.12 (PF2); also elsewhere on the board
PF3: U7.13 (PF3); also elsewhere on the board
PF4: U7.14 (PF4); also elsewhere on the board
PF5: U7.15 (PF5)
PF6: U7.18 (PF6)
PF7: U7.19 (PF7); also elsewhere on the board
PF8: U7.20 (PF8); also elsewhere on the board
PF10: U7.22 (PF10)
PF11: U7.49 (PF11)
PF12: U7.50 (PF12)
PF13: U7.53 (PF13)
PF14: U7.54 (PF14)
PF15: U7.55 (PF15)
PG0: U7.56 (PG0); also elsewhere on the board
PG1: U7.57 (PG1); also elsewhere on the board
PG2: U7.87 (PG2); also elsewhere on the board
PG3: U7.88 (PG3); also elsewhere on the board
PG4: U7.89 (PG4); also elsewhere on the board
PG5: U7.90 (PG5); also elsewhere on the board
PG6: U7.91 (PG6)
PG10: U7.125 (PG10)
PG11: U7.126 (PG11)
PG13: U7.128 (PG13)
PG14: U7.129 (PG14)
PG15: U7.132 (PG15)
PPS: U3.37 (1PPS); also elsewhere on the board
PWRKEY: Q2.3 (C), S2.1, S2.2, U3.8 (PWRKEY)
RF_Data: J12.1, U7.73 (PB12)
Right: C33.2, C34.2, C35.1, C36.1, J22.R1, U3.21 (SPK1P)
SIM_CLK: R30.2, U3.31 (SIM_CLK)
SIM_CTS: R28.1, U7.80 (PD11)
SIM_CTSM: R28.2, U3.12 (CTS)
SIM_DATA: R34.2, U3.30 (SIM_DATA)
SIM_DCD: R32.1, U7.79 (PD10)
SIM_DCDM: R32.2, U3.11 (DCD)
SIM_DTR: R31.1, U7.85 (PD14)
SIM_DTRM: R31.2, R36.2, U3.9 (DTR)
SIM_INT: R35.1, U7.82 (PD13)
SIM_INTM: R35.2, U3.10 (RI)
SIM_Power: R11.2, U7.27 (PC1)
SIM_RST: R29.2, U3.32 (SIM_RST)
SIM_RTS: R25.1, U7.81 (PD12)
SIM_RTSM: R25.2, R37.2, U3.13 (RTS)
SIM_RXD: R23.1, U7.78 (PD9)
SIM_RXM: R24.2, R38.2, U3.15 (RXD)
SIM_TXD: R24.1, U7.77 (PD8)
SIM_TXM: R23.2, U3.14 (TXD)
SIM_USB_D+: J7.3 (D+), U3.26 (USB_DP)
SIM_USB_D-: J7.2 (D-), U3.27 (USB_DN)
SIM_VBUS: C8.1, J7.1 (VBUS), U3.25 (VCHG)
SIM_VDD: C32.2, J20.C1 (VCC), U3.29 (SIM_VDD), U11.4
SPI1_CS_Flash: U7.127 (PG12), U8.1 (~CS)
SPI1_MISO: U7.134 (PB4), U8.2 (DO(IO1))
SPI1_MOSI: U7.135 (PB5), U8.5 (DI(IO0))
SPI1_SCK: U7.133 (PB3), U8.6 (CLK)
SPI2_CS_SD: J14.2 (CD/DAT3), U7.36 (PA2)
SPI2_MISO: J14.7 (DAT0), U7.28 (PC2)
SPI2_MOSI: J14.3 (CMD), U7.29 (PC3)
SPI2_SCK: J14.5 (CLX), U7.69 (PB10)
SPI3_CS_LCD: J17.3, U7.118 (PD4)
SPI3_CS_Touch: J17.11, U7.110 (PA15)
SPI3_MISO: J17.9, J17.13, U7.112 (PC11)
SPI3_MOSI: J17.6, J17.12, U7.113 (PC12)
SPI3_SCK: J17.7, J17.10, U7.111 (PC10)
STATUS: U3.49 (STATUS); also elsewhere on the board
SWCLK: R9.2, U7.109 (PA14)
SWDIO: R10.2, U7.105 (PA13)
TIM3_CH2: R40.1, U7.43 (PA7)
TIM3_CH3: R41.1, U7.46 (PB0)
TIM3_CH4: R42.1, U7.47 (PB1)
Touch_INT: J17.14, U7.102 (PA10)
USB_CONN_D+: J8.3 (D+), U4.3 (I/O2)
USB_CONN_D-: J8.2 (D-), U4.1 (I/O1)
USB_D+: U4.4 (I/O2), U7.104 (PA12)
USB_D-: U4.6 (I/O1), U7.103 (PA11)
VBUS: F1.2, J8.1 (VBUS), Q1.1 (G), Q1.2 (S), R6.1
VRTC: C7.1, U3.17 (VRTC)
WIFI_EN: U5.3 (EN), U7.124 (PG9)
WIFI_RST: U5.1 (RST), U7.123 (PD7)
WIFI_RX: U5.16 (TXD0), U7.122 (PD6)
WIFI_TX: U5.15 (RXD0), U7.119 (PD5)

Notes on the sheet:
Shunting device
128Mb NOR FLASH
OBD
Antennas Ports
CAM_PWD_GND
CAM Port
Ferrite act as a resistor at high freq
Gyro
Crystal
SPI Screen Port
Buttons
CAN RX > HIGH, CAN TX > LOW
Not: Some microcontrollers does not have a usb (pull up usb resistort etc..)
BOOT & RUN
RGB/Blink LED
SD CARD
Protection
Higher wedth = lower inductence
WIFI
Microphone and Speaker Jack
M.Holes
CAM_RST_3.3V
Li-Po Charger
Reverse polarity protection
Can Transceiver
SIM808 Power Management
STM32F4 > SIM808 Connection
USB & Power
5V to 3.3V Buck
MCU Decoupling
STM32F4 Microprocessor
SIM808 GPS/GSM
Cload=2*(CL-Cstray)
Debugger Port (ST Link)
SIM Connections
Analog Filter
+ & - means dif pairs

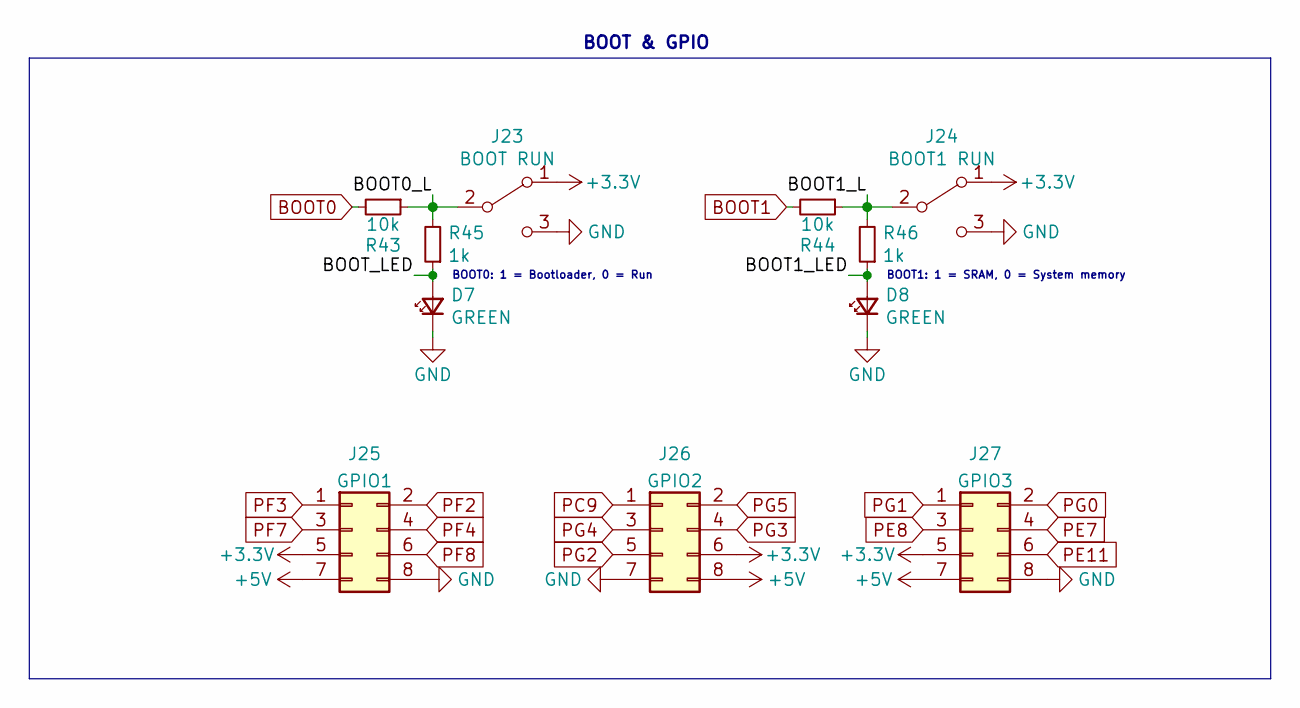
[picture p13: schematic BOOT_GPIO.kicad_sch]

Parts:
D7, D8: GREEN; LED_0603_1608Metric; LCSC C72043
J23: BOOT RUN; PinHeader_1x03_P2.54mm_Vertical
J24: BOOT1 RUN; PinHeader_1x03_P2.54mm_Vertical
J25: GPIO1; PinHeader_2x04_P2.54mm_Vertical
J26: GPIO2; PinHeader_2x04_P2.54mm_Vertical
J27: GPIO3; PinHeader_2x04_P2.54mm_Vertical
R43, R44: 10k; R_0402_1005Metric; LCSC C25744
R45, R46: 1k; R_0402_1005Metric; LCSC C11702

Connections:
+3V3: J23.1 (A), J24.1 (A), J25.5, J26.6, J27.5; also elsewhere on the board
+5V: J25.7, J26.8, J27.7; also elsewhere on the board
/BOOT_GPIO/BOOT0_L: J23.2 (B), R43.1, R45.2
/BOOT_GPIO/BOOT1_L: J24.2 (B), R44.1, R46.2
/BOOT_GPIO/BOOT1_LED: D8.2 (A), R46.1
/BOOT_GPIO/BOOT_LED: D7.2 (A), R45.1
BOOT0: R43.2; also elsewhere on the board
BOOT1: R44.2; also elsewhere on the board
GND: D7.1 (K), D8.1 (K), J23.3 (C), J24.3 (C), J25.8, J26.7, J27.8; also elsewhere on the board
PC9: J26.1; also elsewhere on the board
PE7: J27.4; also elsewhere on the board
PE8: J27.3; also elsewhere on the board
PE11: J27.6; also elsewhere on the board
PF2: J25.2; also elsewhere on the board
PF3: J25.1; also elsewhere on the board
PF4: J25.4; also elsewhere on the board
PF7: J25.3; also elsewhere on the board
PF8: J25.6; also elsewhere on the board
PG0: J27.2; also elsewhere on the board
PG1: J27.1; also elsewhere on the board
PG2: J26.5; also elsewhere on the board
PG3: J26.4; also elsewhere on the board
PG4: J26.3; also elsewhere on the board
PG5: J26.2; also elsewhere on the board

Notes on the sheet:
BOOT1: 1 = SRAM, 0 = System memory
BOOT & GPIO
BOOT0: 1 = Bootloader, 0 = Run

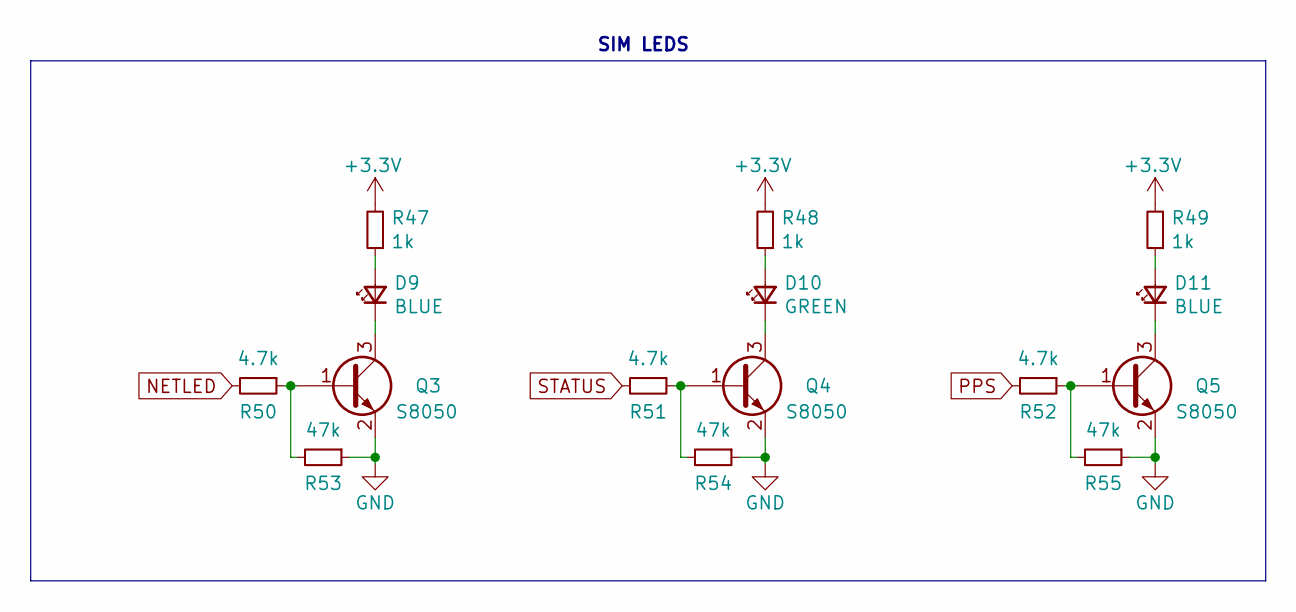
[picture p14: schematic SIM_LEDS.kicad_sch]

Parts:
D9, D11: BLUE; LED_0603_1608Metric; LCSC C72041
D10: GREEN; LED_0603_1608Metric; LCSC C72043
Q3, Q4, Q5: S8050; SOT-23; LCSC C2146
R47, R48, R49: 1k; R_0402_1005Metric; LCSC C11702
R50, R51, R52: 4.7k; R_0402_1005Metric; LCSC C25900
R53, R54, R55: 47k; R_0402_1005Metric; LCSC C25792

Connections:
+3V3: R47.2, R48.2, R49.2; also elsewhere on the board
GND: Q3.2 (E), Q4.2 (E), Q5.2 (E), R53.1, R54.1, R55.1; also elsewhere on the board
NETLED: R50.2; also elsewhere on the board
unnamed: D9.1 (K), Q3.3 (C)
unnamed: D9.2 (A), R47.1
unnamed: D10.1 (K), Q4.3 (C)
unnamed: D10.2 (A), R48.1
unnamed: D11.1 (K), Q5.3 (C)
unnamed: D11.2 (A), R49.1
unnamed: Q3.1 (B), R50.1, R53.2
unnamed: Q4.1 (B), R51.1, R54.2
unnamed: Q5.1 (B), R52.1, R55.2
PPS: R52.2; also elsewhere on the board
STATUS: R51.2; also elsewhere on the board

Notes on the sheet:
SIM LEDS

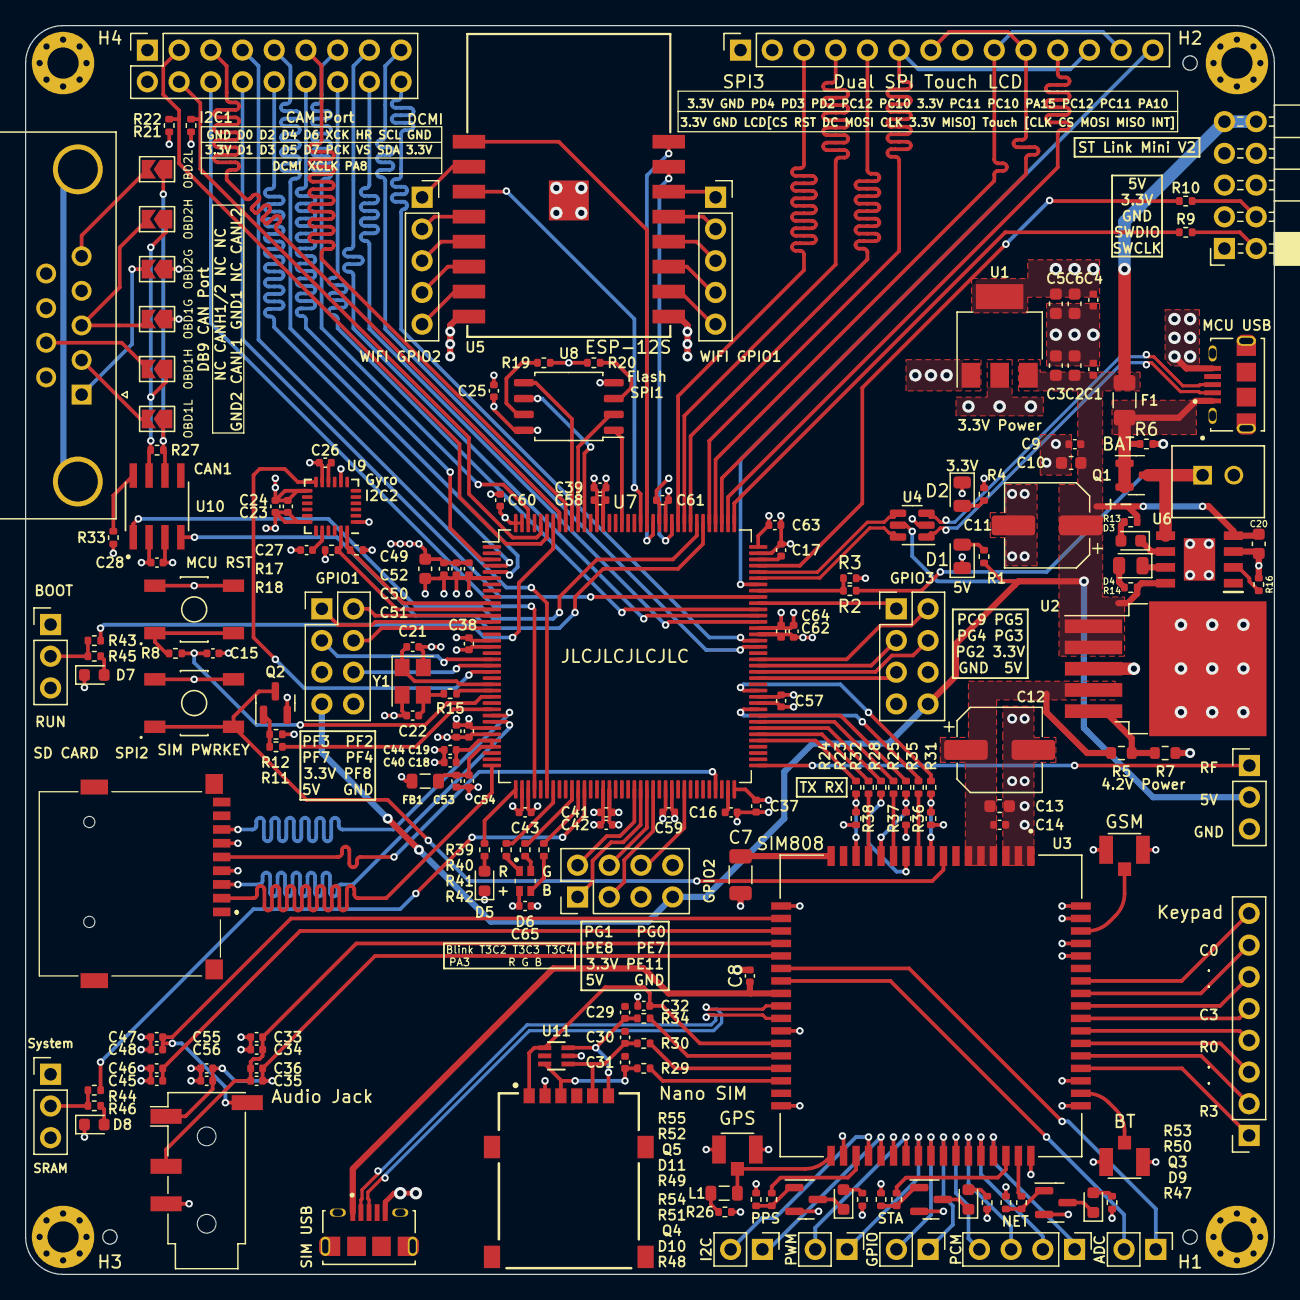
[picture p15: board UnderControl_V6.kicad_pcb from above]

Board: 4 copper layers, 100.0 x 100.0 mm, 190 parts (0 on the bottom side), 192 nets.
