jeremynguyenn/STM32-IoT-Development-board-Hardware-and-Firmware/IOT development board firmware and hardware/UnderControl_Code_Examples-main/UnderControl_Touch_LCD_LVGL/F407_LCD_TOUCH/Core/Src/main.c

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
/* Includes ------------------------------------------------------------------*/
#include "main.h"
#include "dma.h"
#include "spi.h"
#include "tim.h"
#include "gpio.h"

/* USER CODE BEGIN Includes */
#include "lvgl/lvgl.h"
#include "hal_stm_lvgl/tft/tft.h"
#include "hal_stm_lvgl/touch/touchpad.h"
#include "lv_examples.h"
/* USER CODE END Includes */


void SystemClock_Config(void);
/**
  * @brief  The application entry point.
  * @retval int
  */
int main(void)
{
  /* MCU Configuration--------------------------------------------------------*/

  /* Reset of all peripherals, Initializes the Flash interface and the Systick. */
  HAL_Init();

  /* Configure the system clock */
  SystemClock_Config();

  /* Initialize all configured peripherals */
  MX_GPIO_Init();
  MX_DMA_Init();
  MX_TIM3_Init();
  MX_SPI3_Init();
  /* USER CODE BEGIN 2 */

  lv_init();
  tft_init();
  touchpad_init();

  lv_demo_widgets();

  HAL_TIM_Base_Start_IT(&htim3);

  /* USER CODE END 2 */

  /* Infinite loop */
  /* USER CODE BEGIN WHILE */
  while (1)
  {
    /* USER CODE END WHILE */
	HAL_Delay(25);
	lv_task_handler();
	HAL_GPIO_TogglePin(USER_LED_GPIO_Port, USER_LED_Pin);
    /* USER CODE BEGIN 3 */
  }
  /* USER CODE END 3 */
}

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
/* USER CODE BEGIN 4 */

void HAL_TIM_PeriodElapsedCallback(TIM_HandleTypeDef *htim)
{
  /* Prevent unused argument(s) compilation warning */
  UNUSED(htim);

	if(htim->Instance == TIM3)
	{
		lv_tick_inc(5);      /*Tell LVGL that 5 milliseconds were elapsed*/
	}

  /* NOTE : This function should not be modified, when the callback is needed,
            the HAL_TIM_PeriodElapsedCallback could be implemented in the user file
   */
}

/* USER CODE END 4 */
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
