jeremynguyenn/STM32-IoT-Development-board-Hardware-and-Firmware/IOT development board firmware and hardware/UnderControl_Code_Examples-main/OV7670_ILI9341/Core/Inc/main.h

#define BTN_CAP_Pin GPIO_PIN_7
#define BTN_CAP_GPIO_Port GPIOF
#define BTN_MODE_Pin GPIO_PIN_8
#define BTN_MODE_GPIO_Port GPIOF
#define SD_MISO_Pin GPIO_PIN_2
#define SD_MISO_GPIO_Port GPIOC
#define SD_MOSI_Pin GPIO_PIN_3
#define SD_MOSI_GPIO_Port GPIOC
#define SD_CS_Pin GPIO_PIN_2
#define SD_CS_GPIO_Port GPIOA
#define USER_LED_Pin GPIO_PIN_3
#define USER_LED_GPIO_Port GPIOA
#define ROT_A_Pin GPIO_PIN_0
#define ROT_A_GPIO_Port GPIOG
#define ROT_B_Pin GPIO_PIN_1
#define ROT_B_GPIO_Port GPIOG
#define BTN_ROT_Pin GPIO_PIN_7
#define BTN_ROT_GPIO_Port GPIOE
#define SD_SCK_Pin GPIO_PIN_10
#define SD_SCK_GPIO_Port GPIOB
#define CAMERA_RESET_Pin GPIO_PIN_7
#define CAMERA_RESET_GPIO_Port GPIOG
#define CAMERA_PWD_Pin GPIO_PIN_8
#define CAMERA_PWD_GPIO_Port GPIOG
#define TOUCH_IRQ_Pin GPIO_PIN_10
#define TOUCH_IRQ_GPIO_Port GPIOA
#define TOUCH_CS_Pin GPIO_PIN_15
#define TOUCH_CS_GPIO_Port GPIOA
#define LCD_SCK_Pin GPIO_PIN_10
#define LCD_SCK_GPIO_Port GPIOC
#define LCD_MISO_Pin GPIO_PIN_11
#define LCD_MISO_GPIO_Port GPIOC
#define LCD_MOSI_Pin GPIO_PIN_12
#define LCD_MOSI_GPIO_Port GPIOC
#define LCD_DC_Pin GPIO_PIN_2
#define LCD_DC_GPIO_Port GPIOD
#define LCD_RST_Pin GPIO_PIN_3
#define LCD_RST_GPIO_Port GPIOD
#define LCD_CS_Pin GPIO_PIN_4
#define LCD_CS_GPIO_Port GPIOD
