jeremynguyenn/STM32-IoT-Development-board-Hardware-and-Firmware/(notices)

Notices in the files:
IOT development board firmware and hardware/UnderControl_Code_Examples-main/OV7670_ILI9341/Core/Inc/main.h:
© Copyright (c) 2022 STMicroelectronics.
All rights reserved.
This software component is licensed by ST under Ultimate Liberty license
(C) COPYRIGHT STMicroelectronics *****END OF FILE
IOT development board firmware and hardware/UnderControl_Code_Examples-main/UnderControl_Touch_LCD_LVGL/F407_LCD_TOUCH/Core/Src/main.c:
This software component is licensed by ST under BSD 3-Clause license,
the "License"; You may not use this file except in compliance with the
License. You may obtain a copy of the License at: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
